Benedict-Carling/bugg-hardware-main/r6/src/README.txt

Stackup:
Total thickness 1.6mm

Silk
Resist 25um 
F.Cu 35um
Prepreg 0.22mm
In1.Cu 35um
Core 0.3mm
In2.Cu 35um
Prepreg 0.33mm
In3.Cu 35um
Core 0.3mm
In4.Cu 35um
Prepreg 0.22mm
B.Cu 35um
Resist 25um
Silk

DK prepreg assumed: 4.2
Finish: ENIG
Silk: White
Resist: Black, vias tented

See Mousebites-Forbid layer for areas in which mousebites should not be placed.
Mousebites can be placed anywhere on Mic and LED boards.
