Benedict-Carling/bugg-hardware-main/r6/src/bugg-main-r6.kicad_pcb

## KiCad design r6/src/bugg-main-r6.kicad_pcb (2026-09-28)

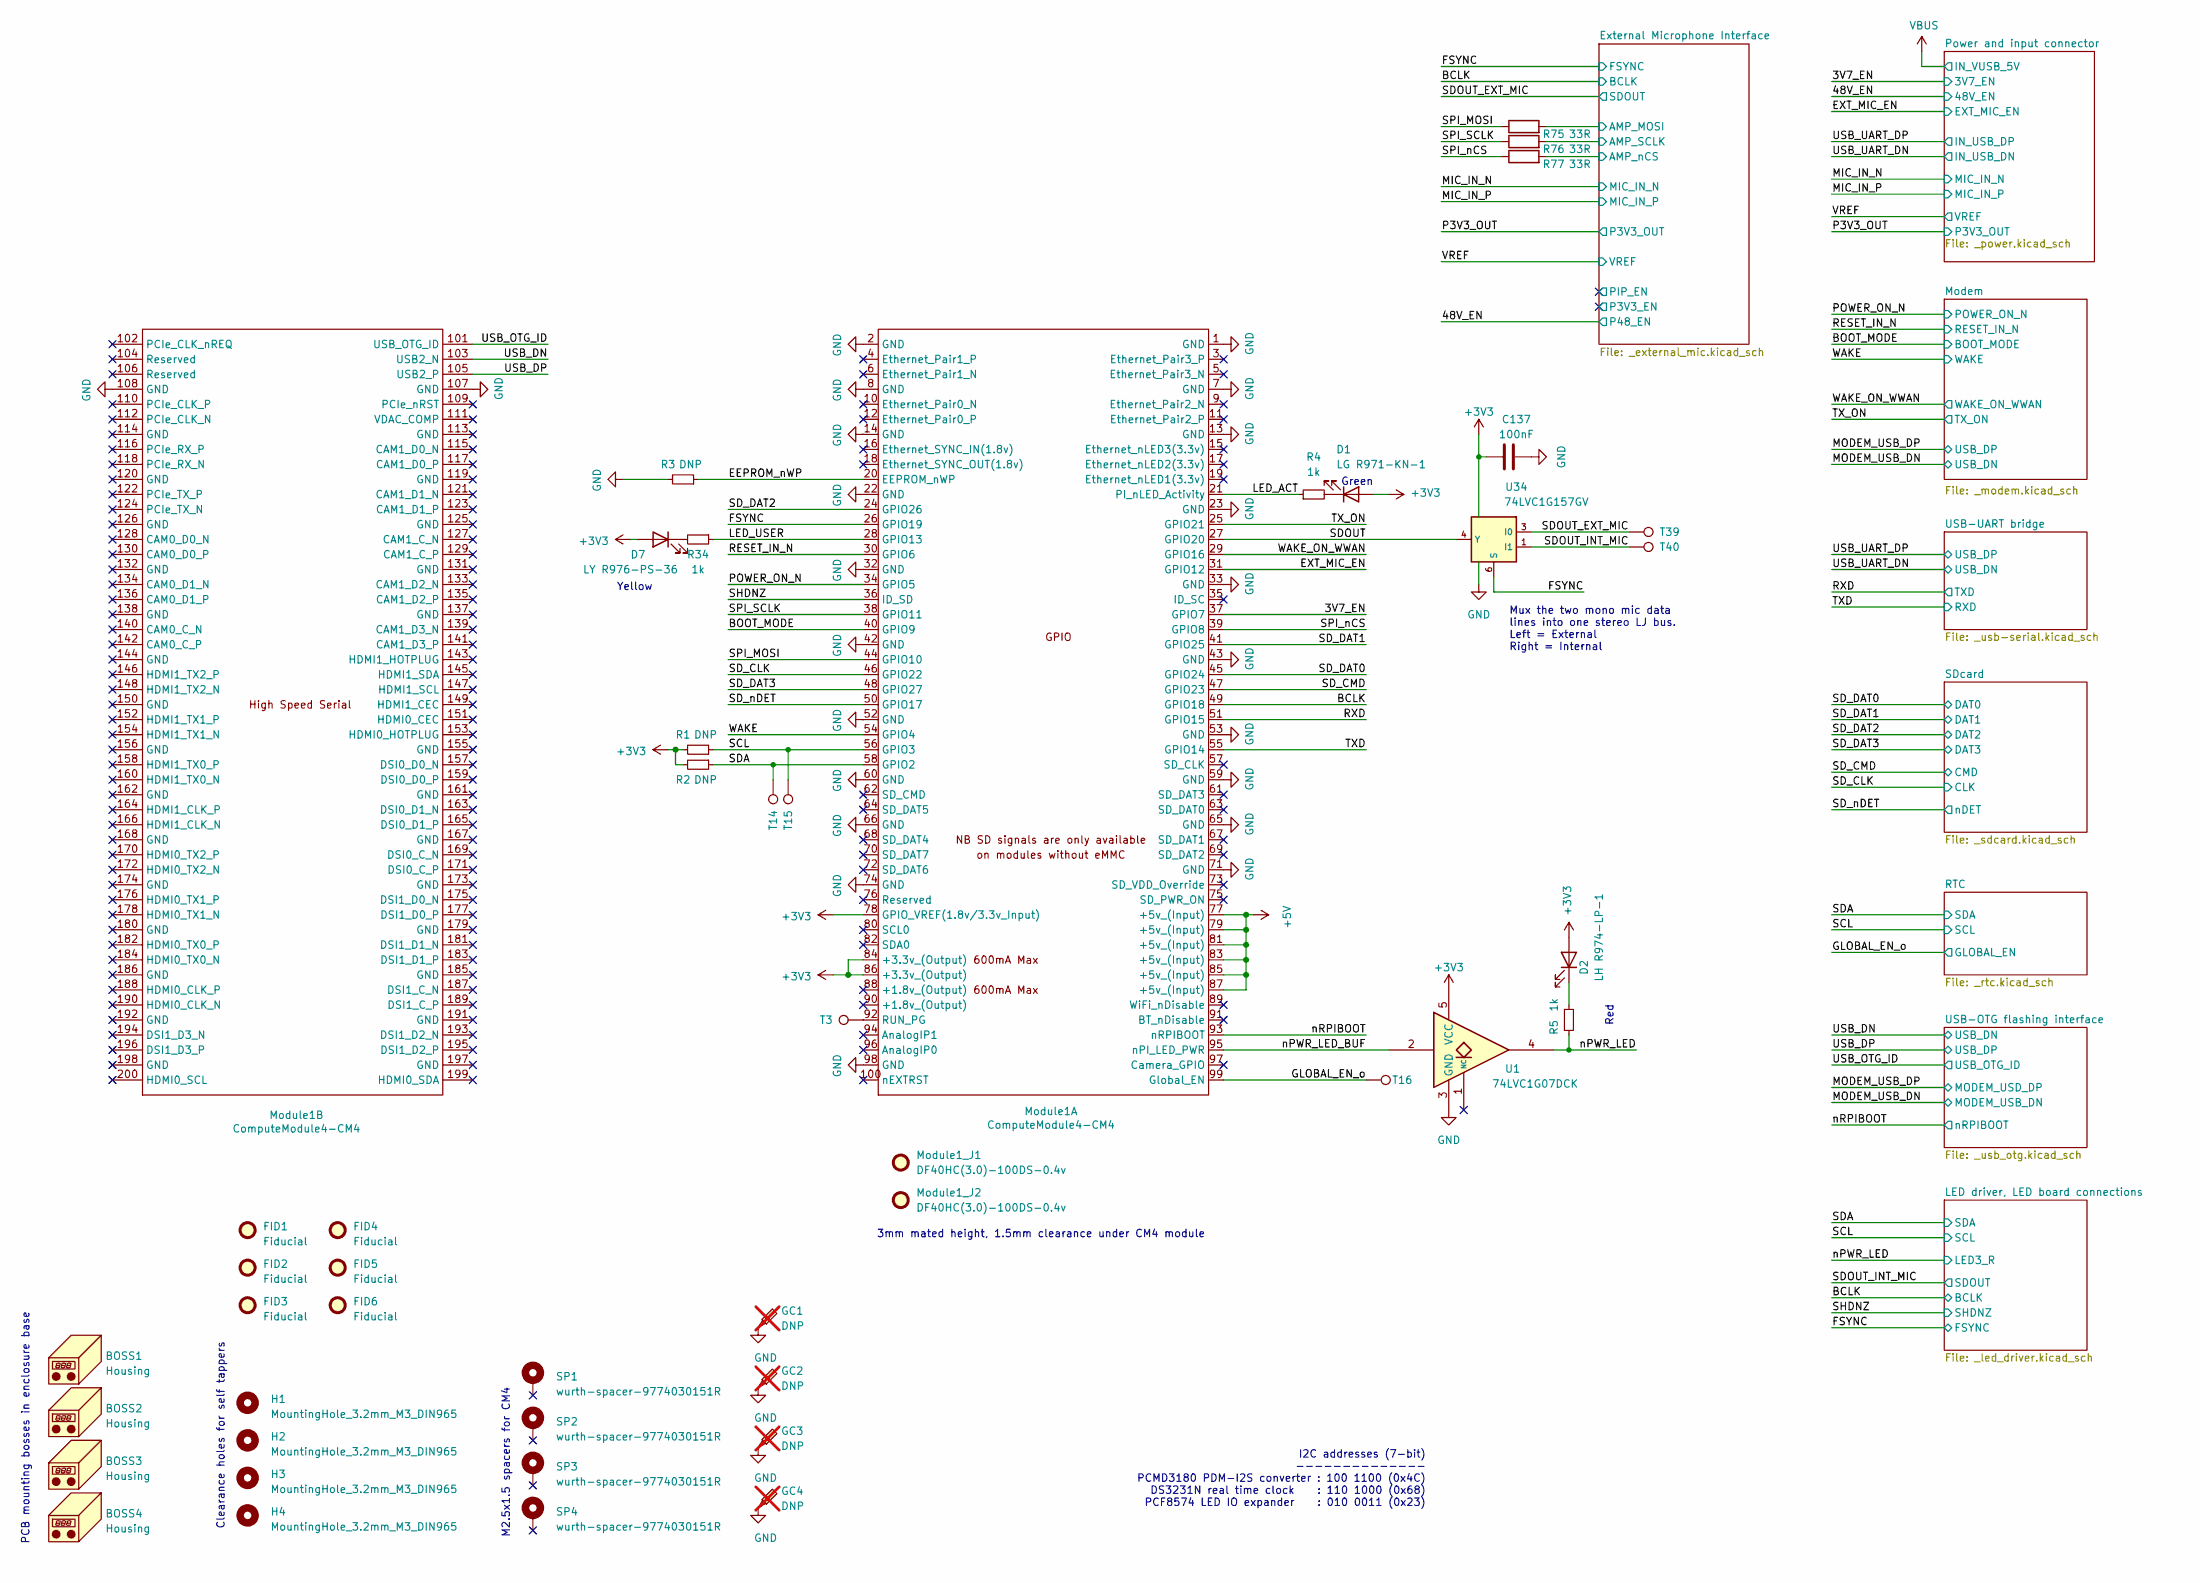
[picture p1: schematic bugg-main-r6.kicad_sch]

Parts:
BOSS1, BOSS2, BOSS3, BOSS4: Housing; bugg-pcb-boss
C137: 100nF; C_0402_1005Metric; Voltage 50V; MPN GRM155R71H104KE14D; Mouser 81-GRM155R71H104KE4D
D1: LG R971-KN-1; CHIPLED-0805; MPN LGR971-KN-1; Digikey 475-1410-6-ND
D2: LH R974-LP-1; CHIPLED-0805; MPN LHR974-LP-1; Digikey 475-1415-6-ND
D7: LY R976-PS-36; CHIPLED-0805; MPN LYR976-PS-36; Digikey 475-2560-6-ND
FID1, FID2, FID3, FID4, FID5, FID6: Fiducial; Fiducial_1mm_Mask2mm
GC1, GC2, GC3, GC4: DNP; TestPoint_Keystone_5019_Minature; MPN 5019; Mouser 534-5019; not fitted
H1, H2, H3, H4: MountingHole_3.2mm_M3_DIN965
Module1: ComputeModule4-CM4; Raspberry-Pi-4-Compute-Module-no-holes; MPN CM4002016; Farnell 3563481
Module1_J1, Module1_J2: DF40HC(3.0)-100DS-0.4v; MPN DF40HC(3.0)-100DS-0.4v; Digikey H124602DKR-ND
R1, R2, R3: DNP; R_0402_1005Metric
R4, R5, R34: 1k; R_0402_1005Metric
R75, R76, R77: 33R; R_0402_1005Metric
SP1, SP2, SP3, SP4: wurth-spacer-9774030151R; wurth-spacer-WA-SMSI-9774030151R; MPN 9774030151R; Digikey 732-7083-6-ND
T3, T14, T15, T16, T39, T40: TestPoint_Pad_D1.0mm
U1: 74LVC1G07DCK; SOT-353_SC-70-5; MPN SN74LVC1G07DCKT; Digikey 296-26591-6-ND
U34: 74LVC1G157GV; SC-74-6_1.5x2.9mm_P0.95mm; MPN 74LVC1G157GV; Mouser 771-74LVC1G157GVQ100

Connections:
+3V3: C137.2, D1.2 (A), D2.2 (A), D7.2 (A), Module1.78 (GPIO_VREF(1.8v/3.3v_Input)), Module1.84 (+3.3v_(Output)), Module1.86 (+3.3v_(Output)), R1.2, R2.2, U1.5 (VCC), U34.5 (VCC); also elsewhere on the board
+5V: Module1.77 (+5v_(Input)), Module1.79 (+5v_(Input)), Module1.81 (+5v_(Input)), Module1.83 (+5v_(Input)), Module1.85 (+5v_(Input)), Module1.87 (+5v_(Input)); also elsewhere on the board
/3V7_EN: Module1.37 (GPIO7); also elsewhere on the board
/BCLK: Module1.49 (GPIO18); also elsewhere on the board
/BOOT_MODE: Module1.40 (GPIO9); also elsewhere on the board
/EEPROM_nWP: Module1.20 (EEPROM_nWP), R3.1
/EXT_MIC_EN: Module1.31 (GPIO12); also elsewhere on the board
/External Microphone Interface/AMP_MOSI: R75.2; also elsewhere on the board
/External Microphone Interface/AMP_SCLK: R76.2; also elsewhere on the board
/External Microphone Interface/AMP_nCS: R77.2; also elsewhere on the board
/FSYNC: Module1.26 (GPIO19), U34.6 (S); also elsewhere on the board
/GLOBAL_EN_o: Module1.99 (Global_EN), T16.1; also elsewhere on the board
/LED_ACT: Module1.21 (PI_nLED_Activity), R4.1
/LED_USER: Module1.28 (GPIO13), R34.1
/POWER_ON_N: Module1.34 (GPIO5); also elsewhere on the board
/RESET_IN_N: Module1.30 (GPIO6); also elsewhere on the board
/RXD: Module1.51 (GPIO15); also elsewhere on the board
/SCL: Module1.56 (GPIO3), R1.1, T15.1; also elsewhere on the board
/SDA: Module1.58 (GPIO2), R2.1, T14.1; also elsewhere on the board
/SDOUT: Module1.27 (GPIO20), U34.4 (Y)
/SDOUT_EXT_MIC: T39.1, U34.3 (I0); also elsewhere on the board
/SDOUT_INT_MIC: T40.1, U34.1 (I1); also elsewhere on the board
/SD_CLK: Module1.46 (GPIO22); also elsewhere on the board
/SD_CMD: Module1.47 (GPIO23); also elsewhere on the board
/SD_DAT0: Module1.45 (GPIO24); also elsewhere on the board
/SD_DAT1: Module1.41 (GPIO25); also elsewhere on the board
/SD_DAT2: Module1.24 (GPIO26); also elsewhere on the board
/SD_DAT3: Module1.48 (GPIO27); also elsewhere on the board
/SD_nDET: Module1.50 (GPIO17); also elsewhere on the board
/SHDNZ: Module1.36 (ID_SD); also elsewhere on the board
/SPI_MOSI: Module1.44 (GPIO10), R75.1
/SPI_SCLK: Module1.38 (GPIO11), R76.1
/SPI_nCS: Module1.39 (GPIO8), R77.1
/TXD: Module1.55 (GPIO14); also elsewhere on the board
/TX_ON: Module1.25 (GPIO21); also elsewhere on the board
/USB_DN: Module1.103 (USB2_N); also elsewhere on the board
/USB_DP: Module1.105 (USB2_P); also elsewhere on the board
/USB_OTG_ID: Module1.101 (USB_OTG_ID); also elsewhere on the board
/WAKE: Module1.54 (GPIO4); also elsewhere on the board
/WAKE_ON_WWAN: Module1.29 (GPIO16); also elsewhere on the board
/nPWR_LED: R5.1, U1.4; also elsewhere on the board
/nPWR_LED_BUF: Module1.95 (nPI_LED_PWR), U1.2
/nRPIBOOT: Module1.93 (nRPIBOOT); also elsewhere on the board
GND: C137.1, GC1.1, GC2.1, GC3.1, GC4.1, Module1.1 (GND), Module1.2 (GND), Module1.7 (GND), Module1.8 (GND), Module1.13 (GND), Module1.14 (GND), Module1.22 (GND), Module1.23 (GND), Module1.32 (GND), Module1.33 (GND), Module1.42 (GND), Module1.43 (GND), Module1.52 (GND), Module1.53 (GND), Module1.59 (GND), Module1.60 (GND), Module1.65 (GND), Module1.66 (GND), Module1.71 (GND), Module1.74 (GND), Module1.98 (GND), Module1.107 (GND), Module1.108 (GND), R3.2, U1.3 (GND), U34.2 (GND); also elsewhere on the board
unnamed: D1.1 (K), R4.2
unnamed: D2.1 (K), R5.2
unnamed: D7.1 (K), R34.2
unnamed: Module1.92 (RUN_PG), T3.1

Notes on the sheet:
Yellow
Red
Mux the two mono mic data lines into one stereo LJ bus. Left = External Right = Internal
Green
3mm mated height, 1.5mm clearance under CM4 module
PCB mounting bosses in enclosure base
Clearance holes for self tappers
I2C addresses (7-bit) -------------- PCMD3180 PDM-I2S converter : 100 1100 (0x4C) DS3231N real time clock : 110 1000 (0x68) PCF8574 LED IO expander : 010 0011 (0x23)
M2.5x1.5 spacers for CM4

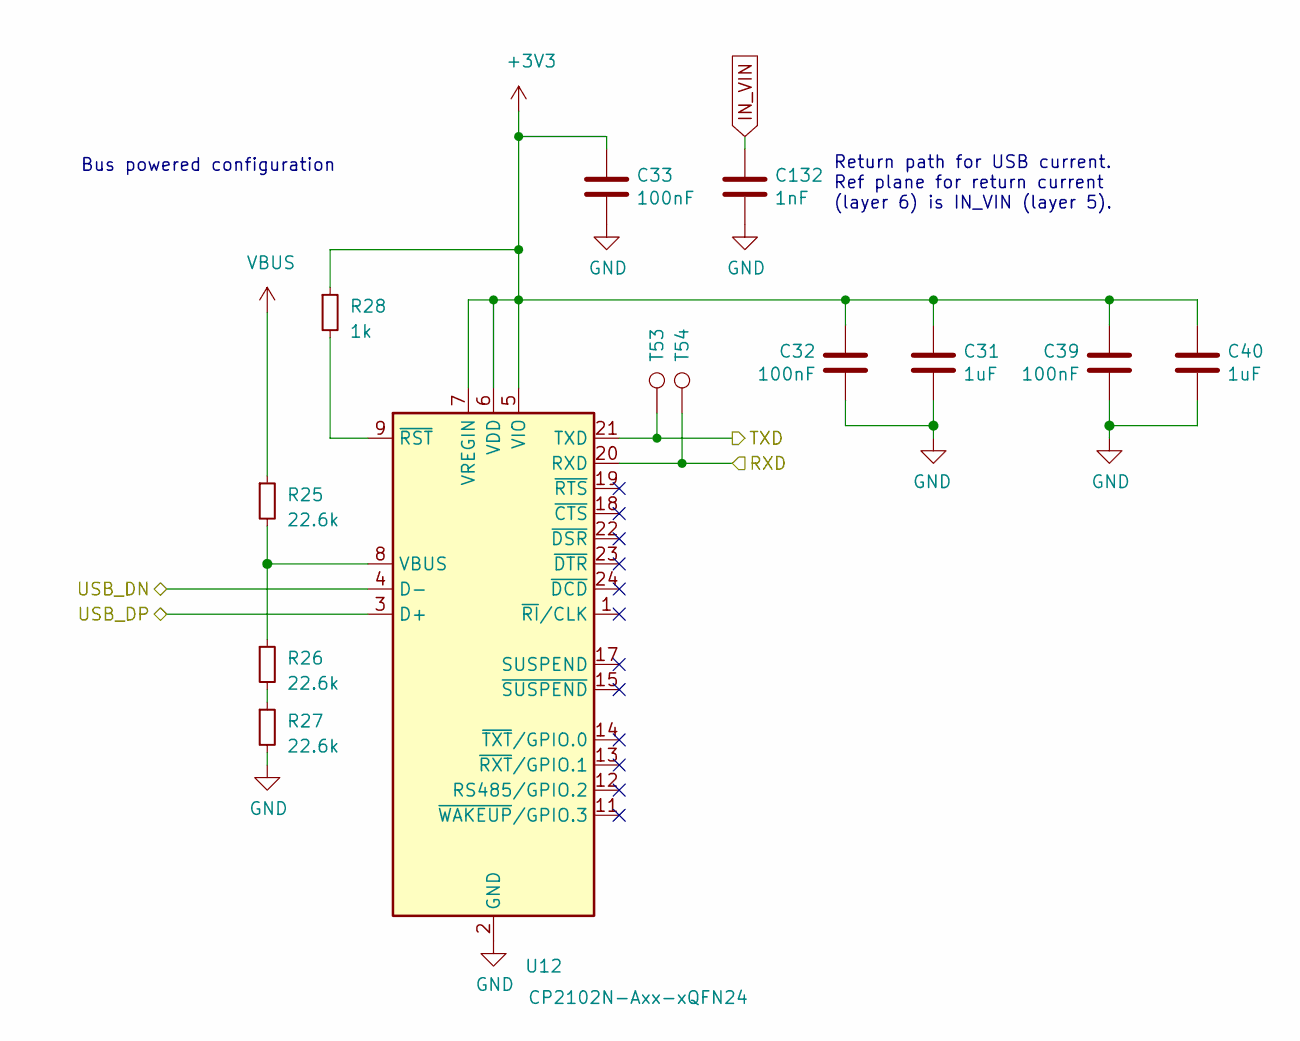
[picture p2: schematic _usb-serial.kicad_sch]

Parts:
C31, C40: 1uF; C_0402_1005Metric; Voltage 6.3V; MPN GRM155C81C105KE15D; Mouser 81-GRM155C81C105KE5D
C32, C33, C39: 100nF; C_0402_1005Metric; Voltage 50V; MPN GRM155R71H104KE14D; Mouser 81-GRM155R71H104KE4D
C132: 1nF; C_0402_1005Metric
R25, R26, R27: 22.6k; R_0402_1005Metric
R28: 1k; R_0402_1005Metric
T53, T54: TestPoint_Pad_D1.0mm
U12: CP2102N-Axx-xQFN24; QFN-24-1EP_4x4mm_P0.5mm_EP2.6x2.6mm; MPN CP2102N-A02-GQFN24R; Digikey 336-5888-6-ND

Connections:
+3V3: C31.1, C32.1, C33.1, C39.1, C40.1, R28.1, U12.5 (VIO), U12.6 (VDD), U12.7 (VREGIN); also elsewhere on the board
/RXD: T53.1, U12.21 (TXD); also elsewhere on the board
/TXD: T54.1, U12.20 (RXD); also elsewhere on the board
/USB_UART_DN: U12.4 (D-); also elsewhere on the board
/USB_UART_DP: U12.3 (D+); also elsewhere on the board
GND: C31.2, C32.2, C33.2, C39.2, C40.2, C132.2, R27.2, U12.2 (GND), U12.25 (GND); also elsewhere on the board
IN_VIN: C132.1; also elsewhere on the board
unnamed: R26.2, R27.1
unnamed: R25.2, R26.1, U12.8 (VBUS)
unnamed: R28.2, U12.9 (~RST)
VBUS: R25.1; also elsewhere on the board

Notes on the sheet:
Return path for USB current. Ref plane for return current (layer 6) is IN_VIN (layer 5).
Bus powered configuration

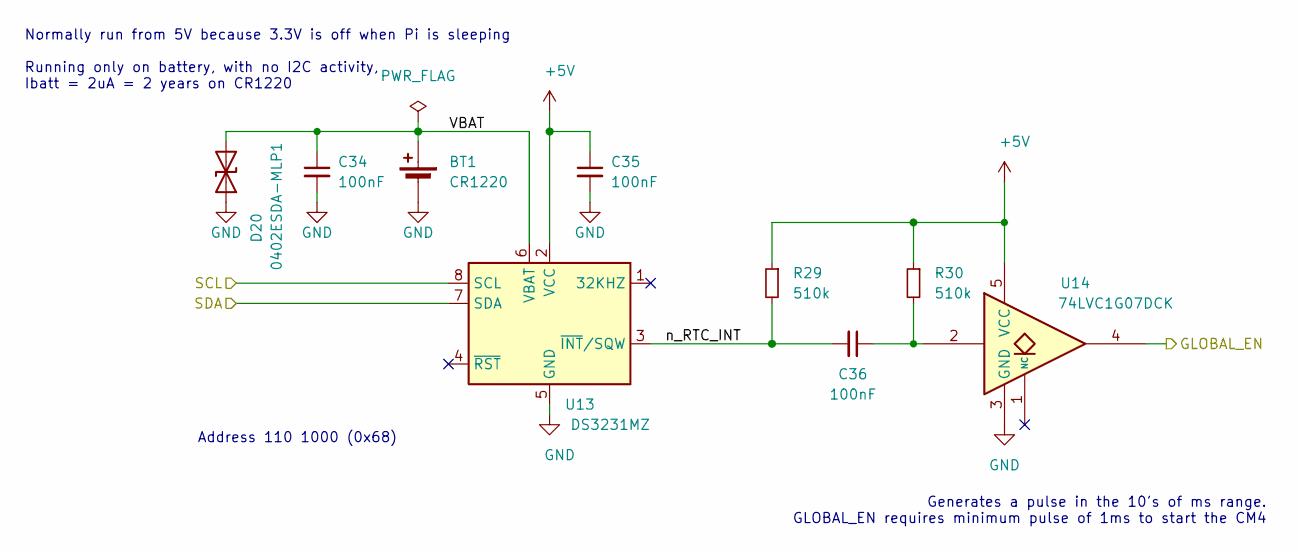
[picture p3: schematic _rtc.kicad_sch]

Parts:
BT1: CR1220; Keystone-3000-CR1220-CR1216; MPN 3000TR; Digikey 36-3000CT-ND
C34, C35, C36: 100nF; C_0402_1005Metric; Voltage 50V; MPN GRM155R71H104KE14D; Mouser 81-GRM155R71H104KE4D
D20: 0402ESDA-MLP1; D_0402_1005Metric; MPN 0402ESDA-MLP1; Digikey 283-2964-6-ND
R29, R30: 510k; R_0402_1005Metric
U13: DS3231MZ; SOIC-8_3.9x4.9mm_P1.27mm; MPN DS3231MZ+; Digikey DS3231MZ+-ND
U14: 74LVC1G07DCK; SOT-353_SC-70-5; MPN SN74LVC1G07DCKT; Digikey 296-26591-6-ND

Connections:
+5V: C35.1, R29.1, R30.1, U13.2 (VCC), U14.5 (VCC); also elsewhere on the board
/GLOBAL_EN_o: U14.4; also elsewhere on the board
/RTC/VBAT: BT1.1 (+), C34.1, D20.2 (A2), U13.6 (VBAT)
/RTC/n_RTC_INT: C36.2, R29.2, U13.3 (~INT/SQW)
/SCL: U13.8 (SCL); also elsewhere on the board
/SDA: U13.7 (SDA); also elsewhere on the board
GND: BT1.2 (-), C34.2, C35.2, D20.1 (A1), U13.5 (GND), U14.3 (GND); also elsewhere on the board
unnamed: C36.1, R30.2, U14.2

Notes on the sheet:
Generates a pulse in the 10's of ms range. GLOBAL_EN requires minimum pulse of 1ms to start the CM4
Address 110 1000 (0x68)
Normally run from 5V because 3.3V is off when Pi is sleeping Running only on battery, with no I2C activity, Ibatt = 2uA = 2 years on CR1220

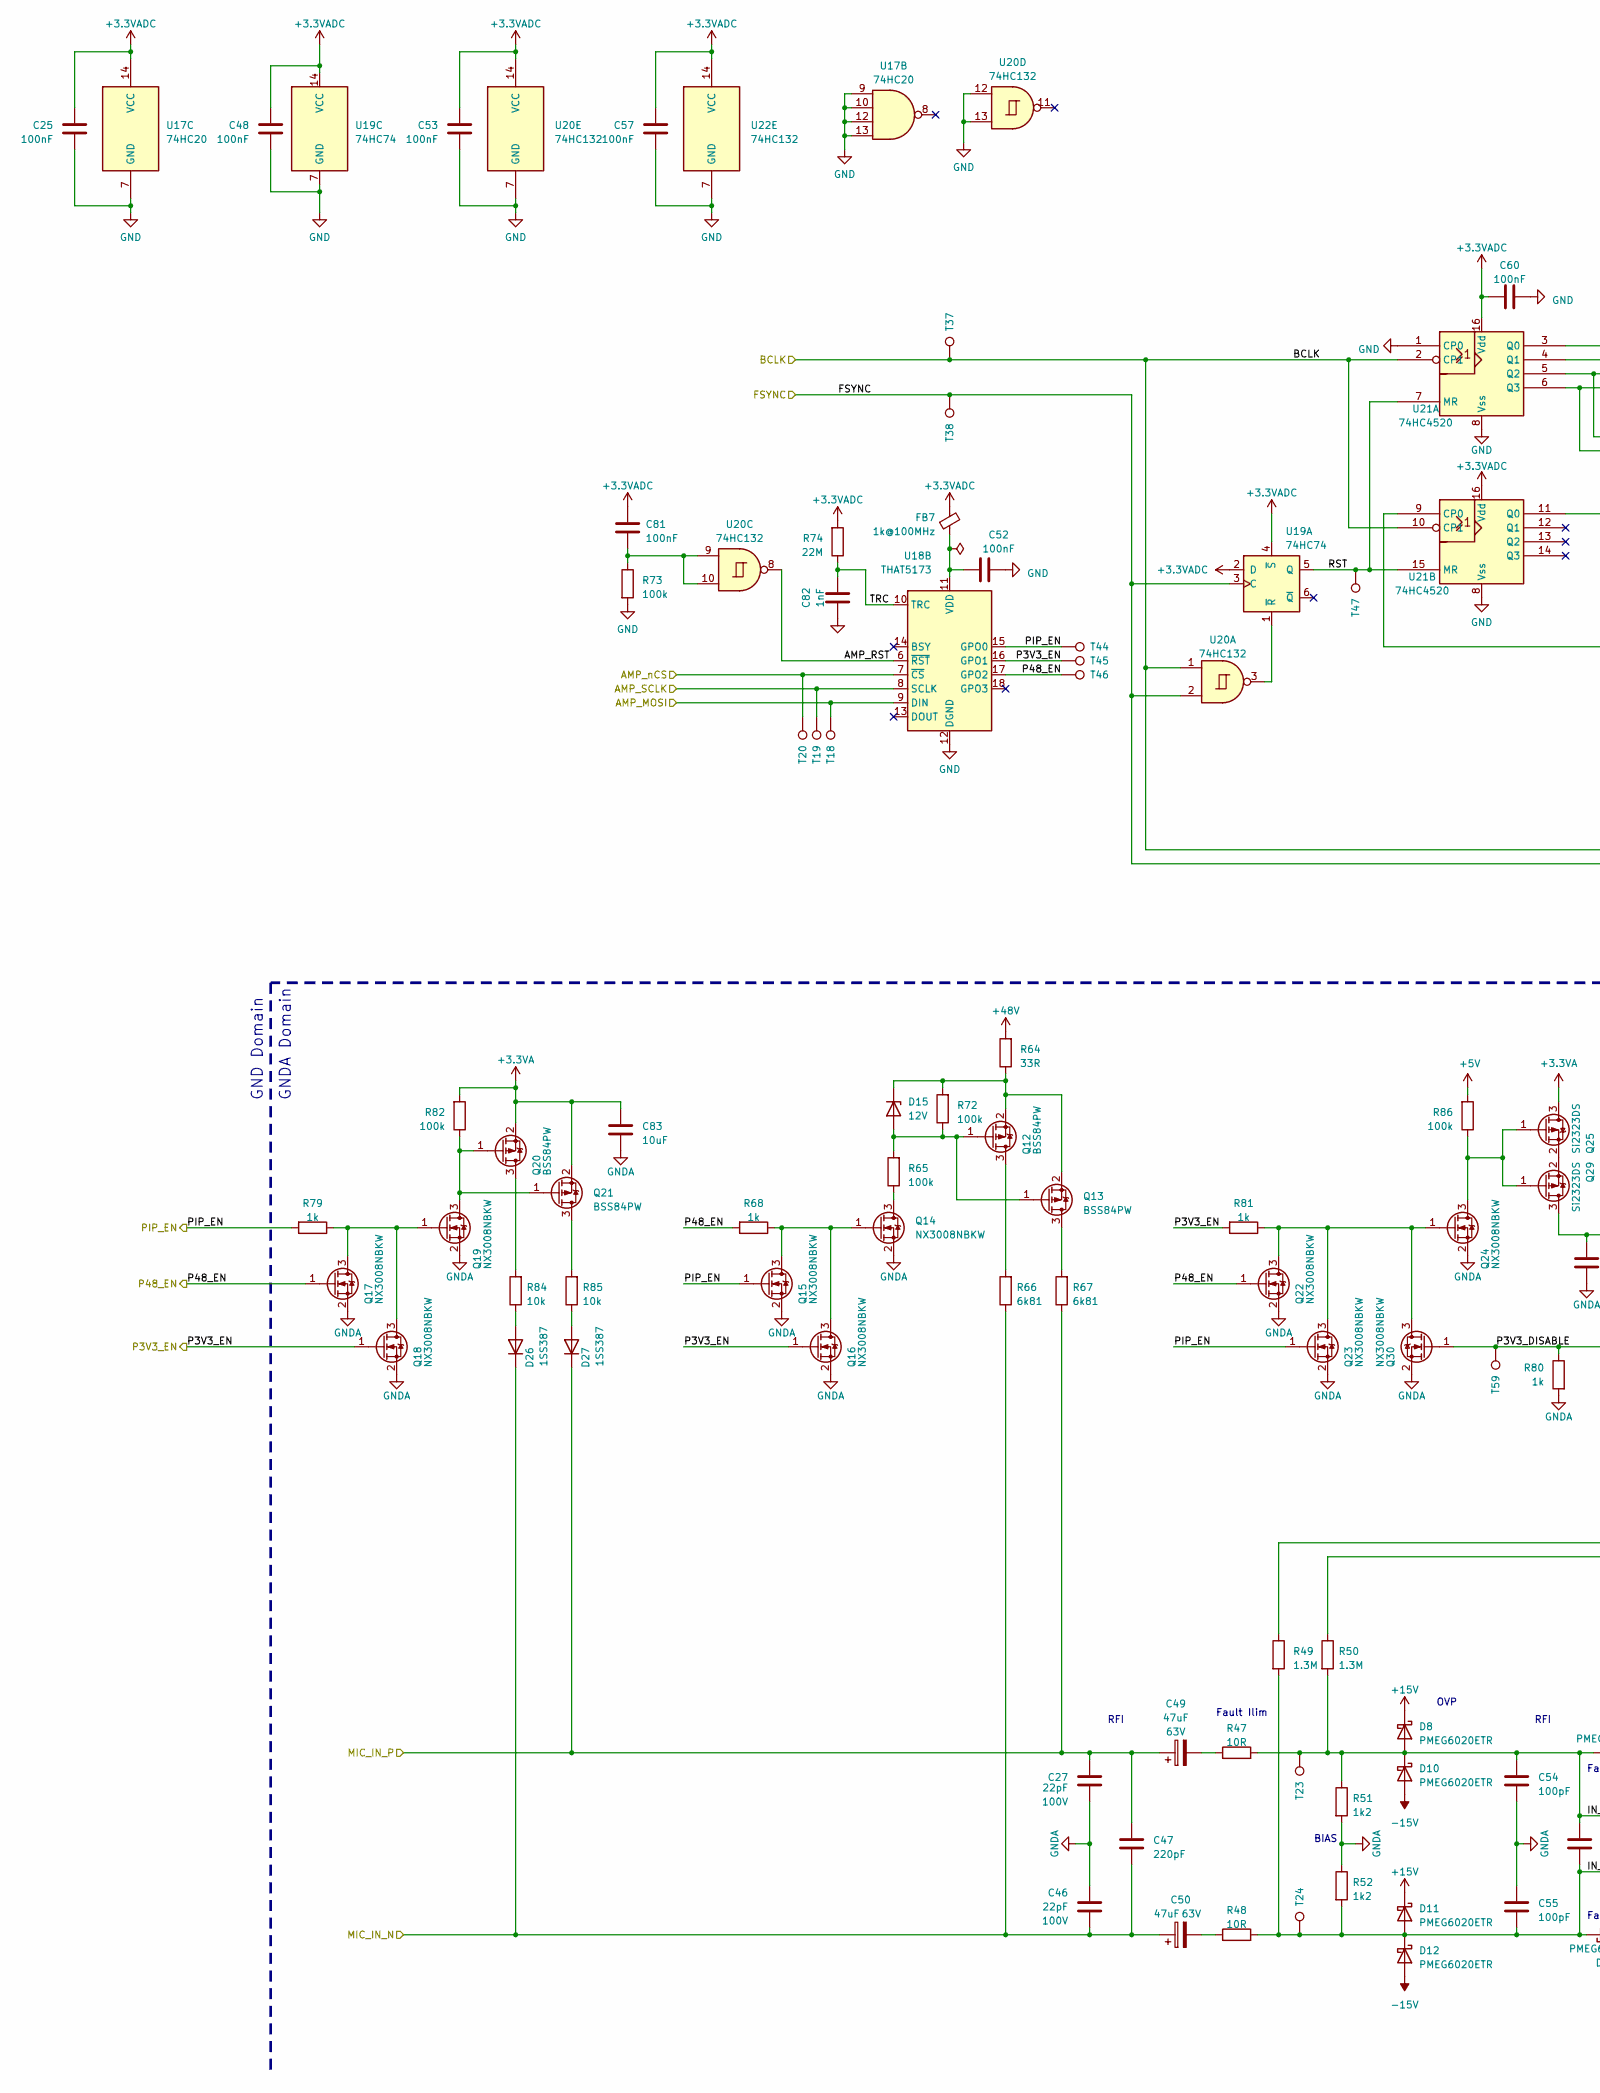
[picture p4: schematic _external_mic.kicad_sch, part in row 1, column 1]

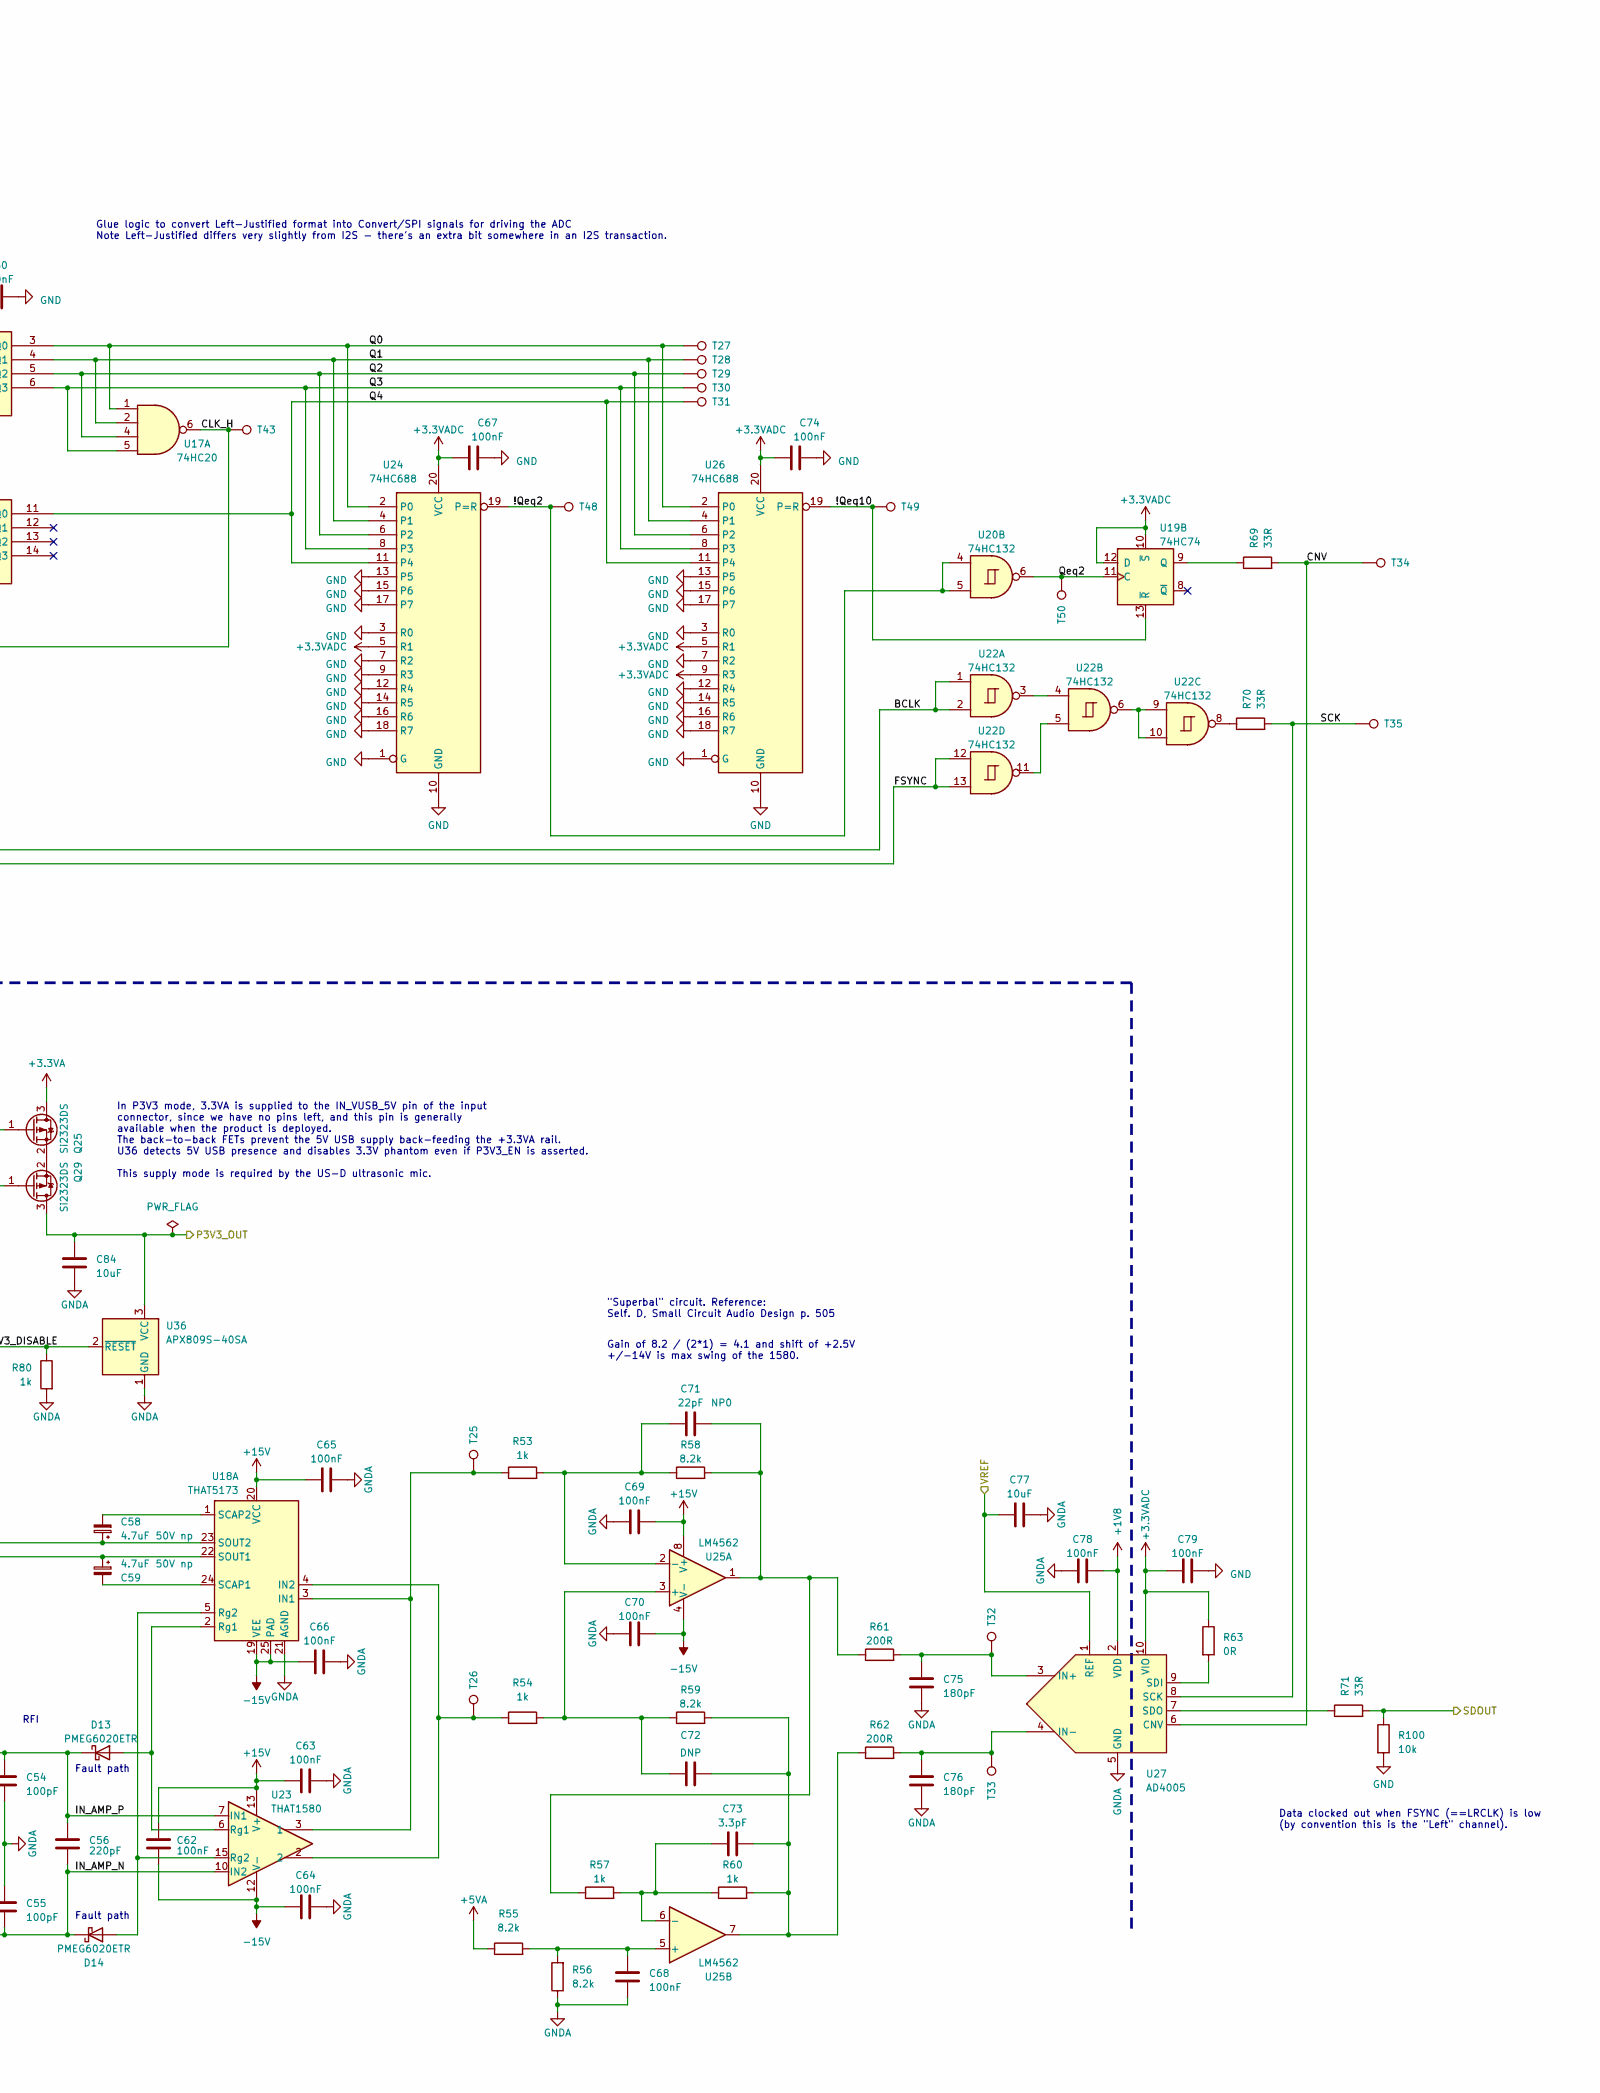
[picture p5: schematic _external_mic.kicad_sch, part in row 1, column 2]

Parts:
C25, C48, C52, C53, C57, C60, C62, C63, C64, C65, C66, C67, C68, C69, C70, C74, C78, C79, C81: 100nF; C_0402_1005Metric; Voltage 50V; MPN GRM155R71H104KE14D; Mouser 81-GRM155R71H104KE4D
C27, C46, C71: 22pF; C_0402_1005Metric; Voltage 100V
C47, C56: 220pF; C_0402_1005Metric
C49, C50: 47uF; CP_Elec_8x10.5; Voltage 63V; MPN EMVH630ADA470MHA0G; Mouser 565-4268-1-ND
C54, C55: 100pF; C_0402_1005Metric
C58, C59: 4.7uF; CP_Elec_5x5.4; Voltage 50V np; MPN 865250642008; Mouser 710-865250642008
C72: DNP; C_0402_1005Metric
C73: 3.3pF; C_0402_1005Metric
C75, C76: 180pF; C_0402_1005Metric
C77, C83, C84: 10uF; C_0603_1608Metric; Voltage 6.3V; MPN CL10A106MQ8NNNC; Mouser 187-CL10A106MQ8NNNC
C82: 1nF; C_0402_1005Metric
D8, D10, D11, D12, D13, D14: PMEG6020ETR; Nexperia_CFP3_SOD-123W; MPN PMEG6020ETR,115; Digikey 1727-1347-1-ND
D15: 12V; D_SOD-123; MPN BZT52C12-13-F; Digikey BZT52C1213-FDIDKR-ND
D26, D27: 1SS387; D_SOD-523; MPN 1SS387,L3F; Mouser 757-1SS387L3F
FB7: 1k@100MHz; L_0603_1608Metric; MPN BLM18KG102SN1D; Digikey 490-17349-1-ND
Q12, Q13, Q20, Q21: BSS84PW; SOT-323_SC-70; MPN BSS84PW; Mouser 726-BSS84PWH6327XTSA
Q14, Q15, Q16, Q17, Q18, Q19, Q22, Q23, Q24, Q30: NX3008NBKW; SOT-323_SC-70; MPN NX3008NBKW; Digikey 1727-1280-6-ND
Q25, Q29: Si2323DS; SOT-23; MPN SI2323DS-T1
R47, R48: 10R; R_1206_3216Metric; Tolerance 0.1%
R49, R50: 1.3M; R_0402_1005Metric
R51, R52: 1k2; R_0402_1005Metric; Tolerance 0.1% thin film; MPN ERA-2AEB122X; Mouser 667-ERA-2AEB122X
R53, R54, R57, R60: 1k; R_0402_1005Metric; Tolerance 0.1% thin film; MPN ERA-2AEB102X; Mouser 667-ERA-2AEB102X
R55, R56, R58, R59: 8.2k; R_0402_1005Metric; Tolerance 0.1% thin film; MPN ERA-2AEB822X; Mouser 667-ERA-2AEB822X
R61, R62: 200R; R_0402_1005Metric; Tolerance 0.1% thin film; MPN ERA-2AEB201X; Mouser 667-ERA-2AEB201X
R63: 0R; R_0402_1005Metric
R64, R69, R70, R71: 33R; R_0402_1005Metric
R65, R72, R73, R82, R86: 100k; R_0402_1005Metric
R66, R67: 6k81; R_1206_3216Metric
R68, R79, R80, R81: 1k; R_0402_1005Metric
R74: 22M; R_0402_1005Metric
R84, R85, R100: 10k; R_0402_1005Metric
T18, T19, T20, T23, T24, T25, T26, T27, T28, T29, T30, T31, T32, T33, T34, T35, T37, T38, T43, T44, T45, T46, T47, T48, T49, T50, T59: TestPoint_Pad_D1.0mm
U17: 74HC20; TSSOP-14_4.4x5mm_P0.65mm; MPN 74HC20PW; Mouser 771-HC20PW118
U18: THAT5173; QFN-24-1EP_5x5mm_P0.65mm_EP3.4x3.4mm_ThermalVias; MPN 5173N24-U; Mouser 887-5173N24-U
U19: 74HC74; TSSOP-14_4.4x5mm_P0.65mm; MPN 74HC74PW; Mouser 771-74HC74PW-T
U20, U22: 74HC132; TSSOP-14_4.4x5mm_P0.65mm; MPN 74HC132PW; Mouser 771-74HC132PW-T
U21: 74HC4520; TSSOP-16_4.4x5mm_P0.65mm; MPN 74HC4520PW; Mouser 771-HC4520PW118
U23: THAT1580; QFN-16-1EP_4x4mm_P0.65mm_EP2.1x2.1mm_ThermalVias; MPN 1580N16-U; Mouser 887-1580N16-U
U24, U26: 74HC688; TSSOP-20_4.4x6.5mm_P0.65mm; MPN 74HC688PW; Mouser 771-HC688PW118
U25: LM4562; SOIC-8_3.9x4.9mm_P1.27mm; MPN LM4562MA; Mouser 926-LM4562MAX/NOPB
U27: AD4005; MSOP-10_3x3mm_P0.5mm; MPN AD4005BRMZ; Mouser 584-AD4005BRMZ
U36: APX809S-40SA; SOT-23; MPN APX809S-40SA; Mouser 621-APX809S-40SA-7

Connections:
+1V8: C78.2, U27.2 (VDD); also elsewhere on the board
+3.3VA: C83.2, Q20.2 (S), Q21.2 (S), Q25.3 (D), R82.2; also elsewhere on the board
+3.3VADC: C25.2, C48.2, C53.2, C57.2, C60.2, C67.2, C74.2, C79.2, C81.1, FB7.2, R63.1, R74.2, U17.14 (VCC), U19.2 (D), U19.4 (~S), U19.10 (~S), U19.12 (D), U19.14 (VCC), U20.14 (VCC), U21.16 (Vdd), U22.14 (VCC), U24.5 (R1), U24.20 (VCC), U26.5 (R1), U26.9 (R3), U26.20 (VCC), U27.10 (VIO); also elsewhere on the board
+5V: R86.2; also elsewhere on the board
+5VA: R55.1; also elsewhere on the board
+15V: C62.1, C63.2, C65.2, C69.2, D8.1 (K), D11.1 (K), U18.20 (VCC), U23.13 (V+), U25.8 (V+); also elsewhere on the board
+48V: R64.2; also elsewhere on the board
-15V: C62.2, C64.1, C66.2, C70.1, D10.2 (A), D12.2 (A), U18.19 (VEE), U18.25 (PAD), U23.12 (V-), U23.17 (V-), U25.4 (V-); also elsewhere on the board
/48V_EN: Q17.1 (G), Q22.1 (G), R68.2, T46.1, U18.17 (GPO2); also elsewhere on the board
/BCLK: T37.1, U20.1, U21.2 (CP1), U21.10 (CP1), U22.1, U22.2; also elsewhere on the board
/External Microphone Interface/!Qeq2: T48.1, U20.4, U20.5, U24.19 (P=R)
/External Microphone Interface/!Qeq10: T49.1, U19.13 (~R), U26.19 (P=R)
/External Microphone Interface/AMP_MOSI: T18.1, U18.9 (DIN); also elsewhere on the board
/External Microphone Interface/AMP_RST: U18.6 (~RST), U20.8
/External Microphone Interface/AMP_SCLK: T19.1, U18.8 (SCLK); also elsewhere on the board
/External Microphone Interface/AMP_nCS: T20.1, U18.7 (~CS); also elsewhere on the board
/External Microphone Interface/CLK_H: T43.1, U17.6, U21.9 (CP0)
/External Microphone Interface/CNV: R69.2, T34.1, U27.6 (CNV)
/External Microphone Interface/IN_AMP_N: C55.1, C56.1, D11.2 (A), D12.1 (K), D14.1 (K), R48.2, R49.2, R52.2, T24.1, U23.10 (IN2)
/External Microphone Interface/IN_AMP_P: C54.2, C56.2, D8.2 (A), D10.1 (K), D13.1 (K), R47.2, R50.2, R51.1, T23.1, U23.7 (IN1)
/External Microphone Interface/P3V3_DISABLE: Q30.1 (G), R80.1, T59.1, U36.2 (~RESET)
/External Microphone Interface/P3V3_EN: Q16.1 (G), Q18.1 (G), R81.2, T45.1, U18.16 (GPO1)
/External Microphone Interface/PIP_EN: Q15.1 (G), Q23.1 (G), R79.2, T44.1, U18.15 (GPO0)
/External Microphone Interface/Q0: T27.1, U17.1, U21.3 (Q0), U24.2 (P0), U26.2 (P0)
/External Microphone Interface/Q1: T28.1, U17.2, U21.4 (Q1), U24.4 (P1), U26.4 (P1)
/External Microphone Interface/Q2: T29.1, U17.4, U21.5 (Q2), U24.6 (P2), U26.6 (P2)
/External Microphone Interface/Q3: T30.1, U17.5, U21.6 (Q3), U24.8 (P3), U26.8 (P3)
/External Microphone Interface/Q4: T31.1, U21.11 (Q0), U24.11 (P4), U26.11 (P4)
/External Microphone Interface/Qeq2: T50.1, U19.11 (C), U20.6
/External Microphone Interface/RST: T47.1, U19.5 (Q), U21.7 (MR), U21.15 (MR)
/External Microphone Interface/SCK: R70.2, T35.1, U27.8 (SCK)
/External Microphone Interface/TRC: C82.2, R74.1, U18.10 (TRC)
/FSYNC: T38.1, U19.3 (C), U20.2, U22.12, U22.13; also elsewhere on the board
/MIC_IN_N: C46.1, C47.1, C50.1, D26.1 (K), R66.1; also elsewhere on the board
/MIC_IN_P: C27.2, C47.2, C49.1, D27.1 (K), R67.1; also elsewhere on the board
/P3V3_OUT: C84.2, Q29.3 (D), U36.3 (VCC); also elsewhere on the board
/SDOUT_EXT_MIC: R71.2, R100.1; also elsewhere on the board
/VREF: C77.2, U27.1 (REF); also elsewhere on the board
GND: C25.1, C48.1, C52.1, C53.1, C57.1, C60.1, C67.1, C74.1, C79.1, C82.1, R73.2, R100.2, U17.7 (GND), U17.9, U17.10, U17.12, U17.13, U18.12 (DGND), U19.7 (GND), U20.7 (GND), U20.12, U20.13, U21.1 (CP0), U21.8 (Vss), U22.7 (GND), U24.1 (G), U24.3 (R0), U24.7 (R2), U24.9 (R3), U24.10 (GND), U24.12 (R4), U24.13 (P5), U24.14 (R5), U24.15 (P6), U24.16 (R6), U24.17 (P7), U24.18 (R7), U26.1 (G), U26.3 (R0), U26.7 (R2), U26.10 (GND), U26.12 (R4), U26.13 (P5), U26.14 (R5), U26.15 (P6), U26.16 (R6), U26.17 (P7), U26.18 (R7); also elsewhere on the board
GNDA: C27.1, C46.2, C54.1, C55.2, C63.1, C64.2, C65.1, C66.1, C68.2, C69.1, C70.2, C75.2, C76.2, C77.1, C78.1, C83.1, C84.1, Q14.2 (S), Q15.2 (S), Q16.2 (S), Q17.2 (S), Q18.2 (S), Q19.2 (S), Q22.2 (S), Q23.2 (S), Q24.2 (S), Q30.2 (S), R51.2, R52.1, R56.1, R80.2, U18.21 (AGND), U27.5 (GND), U36.1 (GND); also elsewhere on the board
unnamed: C49.2, R47.1
unnamed: C50.2, R48.1
unnamed: C71.2, R57.1, R58.2, R61.1, U25.1
unnamed: C72.2, C73.2, R59.2, R60.2, R62.1, U25.7
unnamed: C81.2, R73.1, U20.9, U20.10
unnamed: D13.2 (A), U18.2 (Rg1), U23.6 (Rg1)
unnamed: D14.2 (A), U18.5 (Rg2), U23.15 (Rg2)
unnamed: D15.2 (A), Q12.1 (G), Q13.1 (G), R65.2, R72.1
unnamed: D15.1 (K), Q12.2 (S), Q13.2 (S), R64.1, R72.2
unnamed: D26.2 (A), R84.1
unnamed: D27.2 (A), R85.1
unnamed: Q12.3 (D), R66.2
unnamed: Q13.3 (D), R67.2
unnamed: Q14.3 (D), R65.1
unnamed: Q14.1 (G), Q15.3 (D), Q16.3 (D), R68.1
unnamed: Q17.3 (D), Q18.3 (D), Q19.1 (G), R79.1
unnamed: Q19.3 (D), Q20.1 (G), Q21.1 (G), R82.1
unnamed: Q20.3 (D), R84.2
unnamed: Q21.3 (D), R85.2
unnamed: Q22.3 (D), Q23.3 (D), Q24.1 (G), Q30.3 (D), R81.1
unnamed: Q24.3 (D), Q25.1 (G), Q29.1 (G), R86.1
unnamed: Q25.2 (S), Q29.2 (S)
unnamed: R70.1, U22.8
unnamed: R53.1, T25.1, U18.3 (IN1), U23.3 (1)
unnamed: R54.1, T26.1, U18.4 (IN2), U23.2
unnamed: C59.2, U18.24 (SCAP1)
unnamed: C58.2, U18.1 (SCAP2)
unnamed: C59.1, R50.1, U18.22 (SOUT1)
unnamed: C58.1, R49.1, U18.23 (SOUT2)
unnamed: C52.2, FB7.1, U18.11 (VDD)
unnamed: U19.1 (~R), U20.3
unnamed: R69.1, U19.9 (Q)
unnamed: U22.3, U22.4
unnamed: U22.6, U22.9, U22.10
unnamed: U22.5, U22.11
unnamed: C72.1, R54.2, R59.1, U25.3 (+)
unnamed: C71.1, R53.2, R58.1, U25.2 (-)
unnamed: C68.1, R55.2, R56.2, U25.5 (+)
unnamed: C73.1, R57.2, R60.1, U25.6 (-)
unnamed: C75.1, R61.2, T32.1, U27.3 (IN+)
unnamed: C76.1, R62.2, T33.1, U27.4 (IN-)
unnamed: R63.2, U27.9 (SDI)
unnamed: R71.1, U27.7 (SDO)

Notes on the sheet:
OVP
RFI
Fault path
BIAS
"Superbal" circuit. Reference: Self. D, Small Circuit Audio Design p. 505
Gain of 8.2 / (2*1) = 4.1 and shift of +2.5V +/-14V is max swing of the 1580.
Glue logic to convert Left-Justified format into Convert/SPI signals for driving the ADC Note Left-Justified differs very slightly from I2S - there's an extra bit somewhere in an I2S transaction.
Data clocked out when FSYNC (==LRCLK) is low (by convention this is the "Left" channel).
In P3V3 mode, 3.3VA is supplied to the IN_VUSB_5V pin of the input connector, since we have no pins left, and this pin is generally available when the product is deployed. The back-to-back FETs prevent the 5V USB supply back-feeding the +3.3VA rail. U36 detects 5V USB presence and disables 3.3V pha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
GNDA Domain
Fault Ilim
GND Domain
