Benedict-Carling/bugg-hardware-main/r6/src/bugg-main-r6.kicad_pcb

## KiCad design r6/src/bugg-main-r6.kicad_pcb (continued)

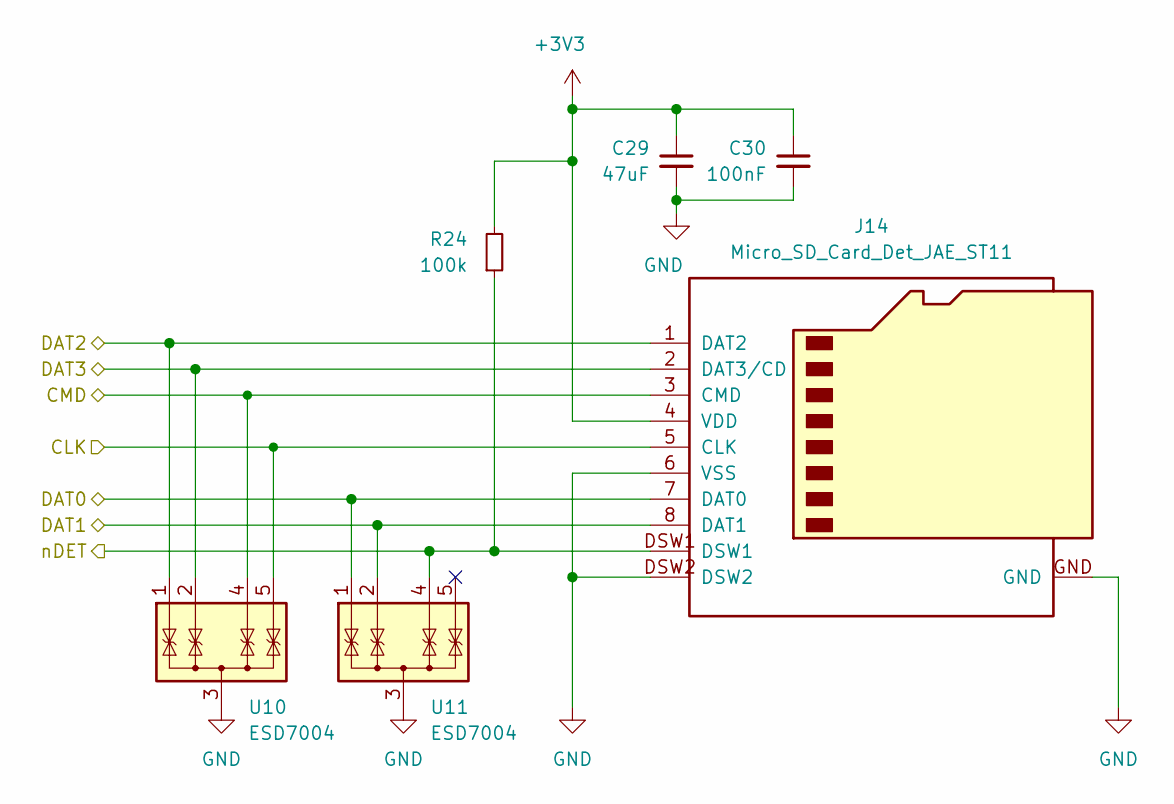
[picture p6: schematic _sdcard.kicad_sch]

Parts:
C29: 47uF; C_1206_3216Metric; Voltage 6.3V; MPN GRM31CE70J476ME15L; Mouser 81-GRM31CE70J476ME5L
C30: 100nF; C_0402_1005Metric; Voltage 50V; MPN GRM155R71H104KE14D; Mouser 81-GRM155R71H104KE4D
J14: Micro_SD_Card_Det_JAE_ST11; microSD_JAE_ST11S008V4H; MPN ST11S008V4HR2000; Digikey 670-2695-6-ND
R24: 100k; R_0402_1005Metric
U10, U11: ESD7004; USON-10_2.5x1.0mm_P0.5mm; MPN ESD7004MUTAG; Digikey ESD7004MUTAGOSDKR-ND

Connections:
+3V3: C29.1, C30.1, J14.4 (VDD), R24.2; also elsewhere on the board
/SD_CLK: J14.5 (CLK), U10.5 (IO4), U10.6; also elsewhere on the board
/SD_CMD: J14.3 (CMD), U10.4 (IO3), U10.7; also elsewhere on the board
/SD_DAT0: J14.7 (DAT0), U11.1 (IO1), U11.10; also elsewhere on the board
/SD_DAT1: J14.8 (DAT1), U11.2 (IO2), U11.9; also elsewhere on the board
/SD_DAT2: J14.1 (DAT2), U10.1 (IO1), U10.10; also elsewhere on the board
/SD_DAT3: J14.2 (DAT3/CD), U10.2 (IO2), U10.9; also elsewhere on the board
/SD_nDET: J14.DSW1, R24.1, U11.4 (IO3), U11.7; also elsewhere on the board
GND: C29.2, C30.2, J14.6 (VSS), J14.DSW2, J14.GND, U10.3 (G), U10.8, U11.3 (G), U11.8; also elsewhere on the board

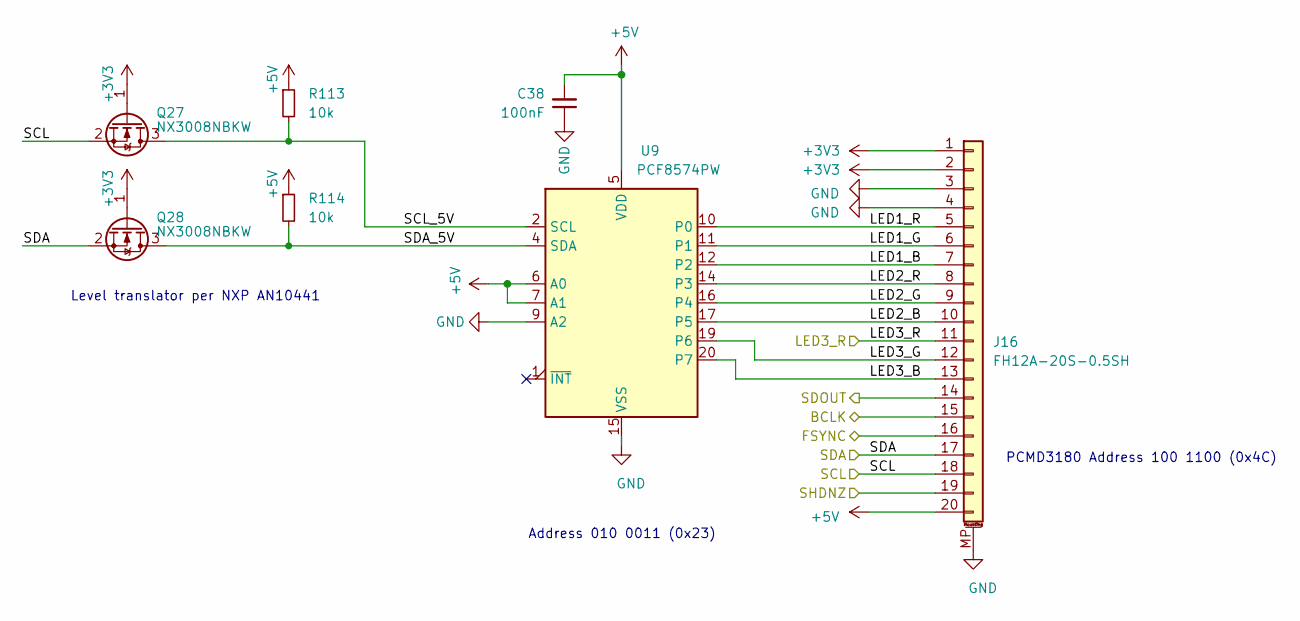
[picture p7: schematic _led_driver.kicad_sch]

Parts:
C38: 100nF; C_0402_1005Metric; Voltage 50V; MPN GRM155R71H104KE14D; Mouser 81-GRM155R71H104KE4D
J16: FH12A-20S-0.5SH; Hirose_FH12-20S-0.5SH_1x20-1MP_P0.50mm_Horizontal; MPN FH12A-20S-0.5SH(55); Digikey HFK120CT-ND
Q27, Q28: NX3008NBKW; SOT-323_SC-70; MPN NX3008NBKW; Digikey 1727-1280-6-ND
R113, R114: 10k; R_0402_1005Metric
U9: PCF8574PW; SSOP-20_4.4x6.5mm_P0.65mm; MPN PCF8574PW; Digikey TI

Connections:
+3V3: J16.1, J16.2, Q27.1 (G), Q28.1 (G); also elsewhere on the board
+5V: C38.2, J16.20, R113.1, R114.1, U9.5 (VDD), U9.6 (A0), U9.7 (A1); also elsewhere on the board
/BCLK: J16.15; also elsewhere on the board
/FSYNC: J16.16; also elsewhere on the board
/LED driver, LED board connections/LED1_B: J16.7, U9.12 (P2)
/LED driver, LED board connections/LED1_G: J16.6, U9.11 (P1)
/LED driver, LED board connections/LED1_R: J16.5, U9.10 (P0)
/LED driver, LED board connections/LED2_B: J16.10, U9.17 (P5)
/LED driver, LED board connections/LED2_G: J16.9, U9.16 (P4)
/LED driver, LED board connections/LED2_R: J16.8, U9.14 (P3)
/LED driver, LED board connections/LED3_B: J16.13, U9.20 (P7)
/LED driver, LED board connections/LED3_G: J16.12, U9.19 (P6)
/LED driver, LED board connections/SCL_5V: Q27.3 (D), R113.2, U9.2 (SCL)
/LED driver, LED board connections/SDA_5V: Q28.3 (D), R114.2, U9.4 (SDA)
/SCL: J16.18, Q27.2 (S); also elsewhere on the board
/SDA: J16.17, Q28.2 (S); also elsewhere on the board
/SDOUT_INT_MIC: J16.14; also elsewhere on the board
/SHDNZ: J16.19; also elsewhere on the board
/nPWR_LED: J16.11; also elsewhere on the board
GND: C38.1, J16.3, J16.4, J16.MP (MountPin), U9.9 (A2), U9.15 (VSS); also elsewhere on the board

Notes on the sheet:
Level translator per NXP AN10441
PCMD3180 Address 100 1100 (0x4C)
Address 010 0011 (0x23)

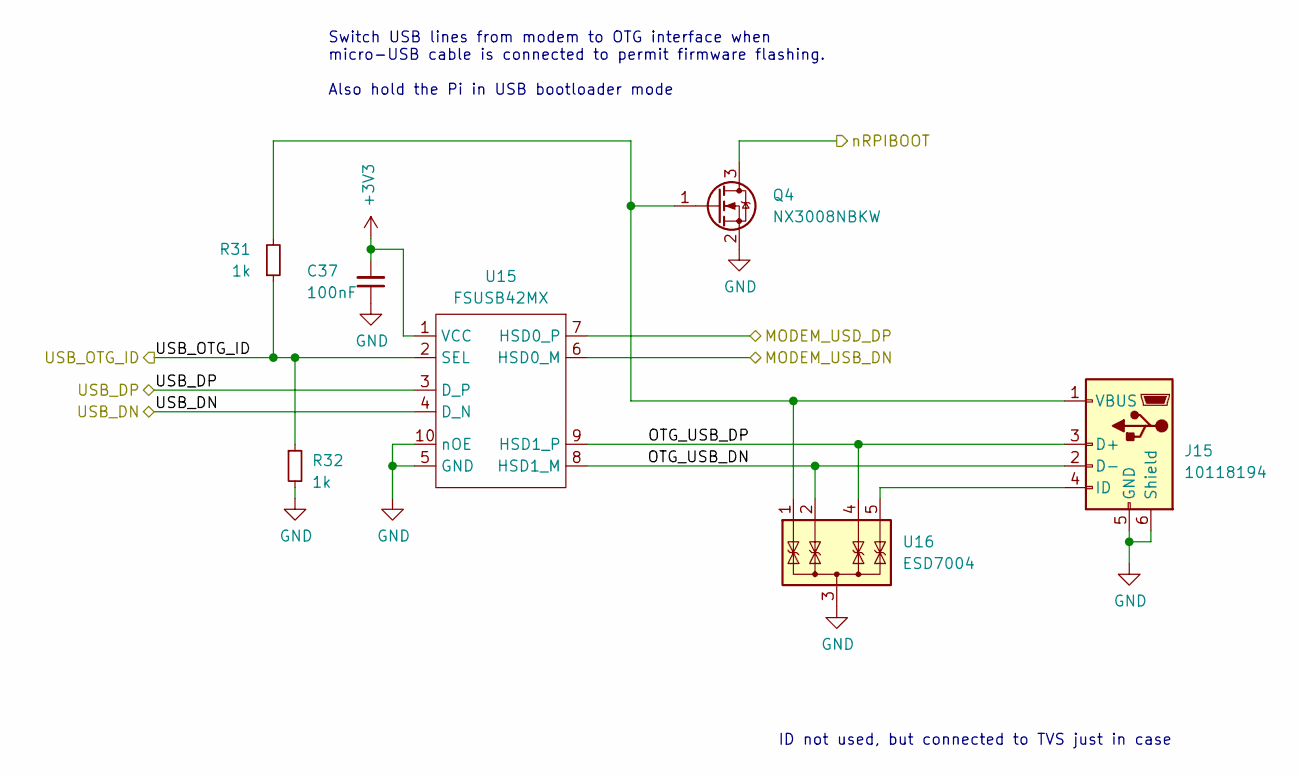
[picture p8: schematic _usb_otg.kicad_sch]

Parts:
C37: 100nF; C_0402_1005Metric; Voltage 50V; MPN GRM155R71H104KE14D; Mouser 81-GRM155R71H104KE4D
J15: 10118194; USB_Micro-B_Amphenol_10118194_Horizontal; MPN 10118194-0001LF; Digikey 609-4618-6-ND
Q4: NX3008NBKW; SOT-323_SC-70; MPN NX3008NBKW; Digikey 1727-1280-6-ND
R31, R32: 1k; R_0402_1005Metric
U15: FSUSB42MX; MSOP-10_3x3mm_P0.5mm; MPN FSUSB42MUX; Digikey FSUSB42MUXDKR-ND
U16: ESD7004; USON-10_2.5x1.0mm_P0.5mm; MPN ESD7004MUTAG; Digikey ESD7004MUTAGOSDKR-ND

Connections:
+3V3: C37.2, U15.1 (VCC); also elsewhere on the board
/MODEM_USB_DN: U15.6 (HSD0_M); also elsewhere on the board
/MODEM_USB_DP: U15.7 (HSD0_P); also elsewhere on the board
/USB-OTG flashing interface/OTG_USB_DN: J15.2 (D-), U15.8 (HSD1_M), U16.2 (IO2), U16.9
/USB-OTG flashing interface/OTG_USB_DP: J15.3 (D+), U15.9 (HSD1_P), U16.4 (IO3), U16.7
/USB_DN: U15.4 (D_N); also elsewhere on the board
/USB_DP: U15.3 (D_P); also elsewhere on the board
/USB_OTG_ID: R31.1, R32.1, U15.2 (SEL); also elsewhere on the board
/nRPIBOOT: Q4.3 (D); also elsewhere on the board
GND: C37.1, J15.5 (GND), J15.6 (Shield), Q4.2 (S), R32.2, U15.5 (GND), U15.10 (nOE), U16.3 (G), U16.8; also elsewhere on the board
unnamed: J15.4 (ID), U16.5 (IO4), U16.6
unnamed: J15.1 (VBUS), Q4.1 (G), R31.2, U16.1 (IO1), U16.10

Notes on the sheet:
Switch USB lines from modem to OTG interface when micro-USB cable is connected to permit firmware flashing. Also hold the Pi in USB bootloader mode
ID not used, but connected to TVS just in case

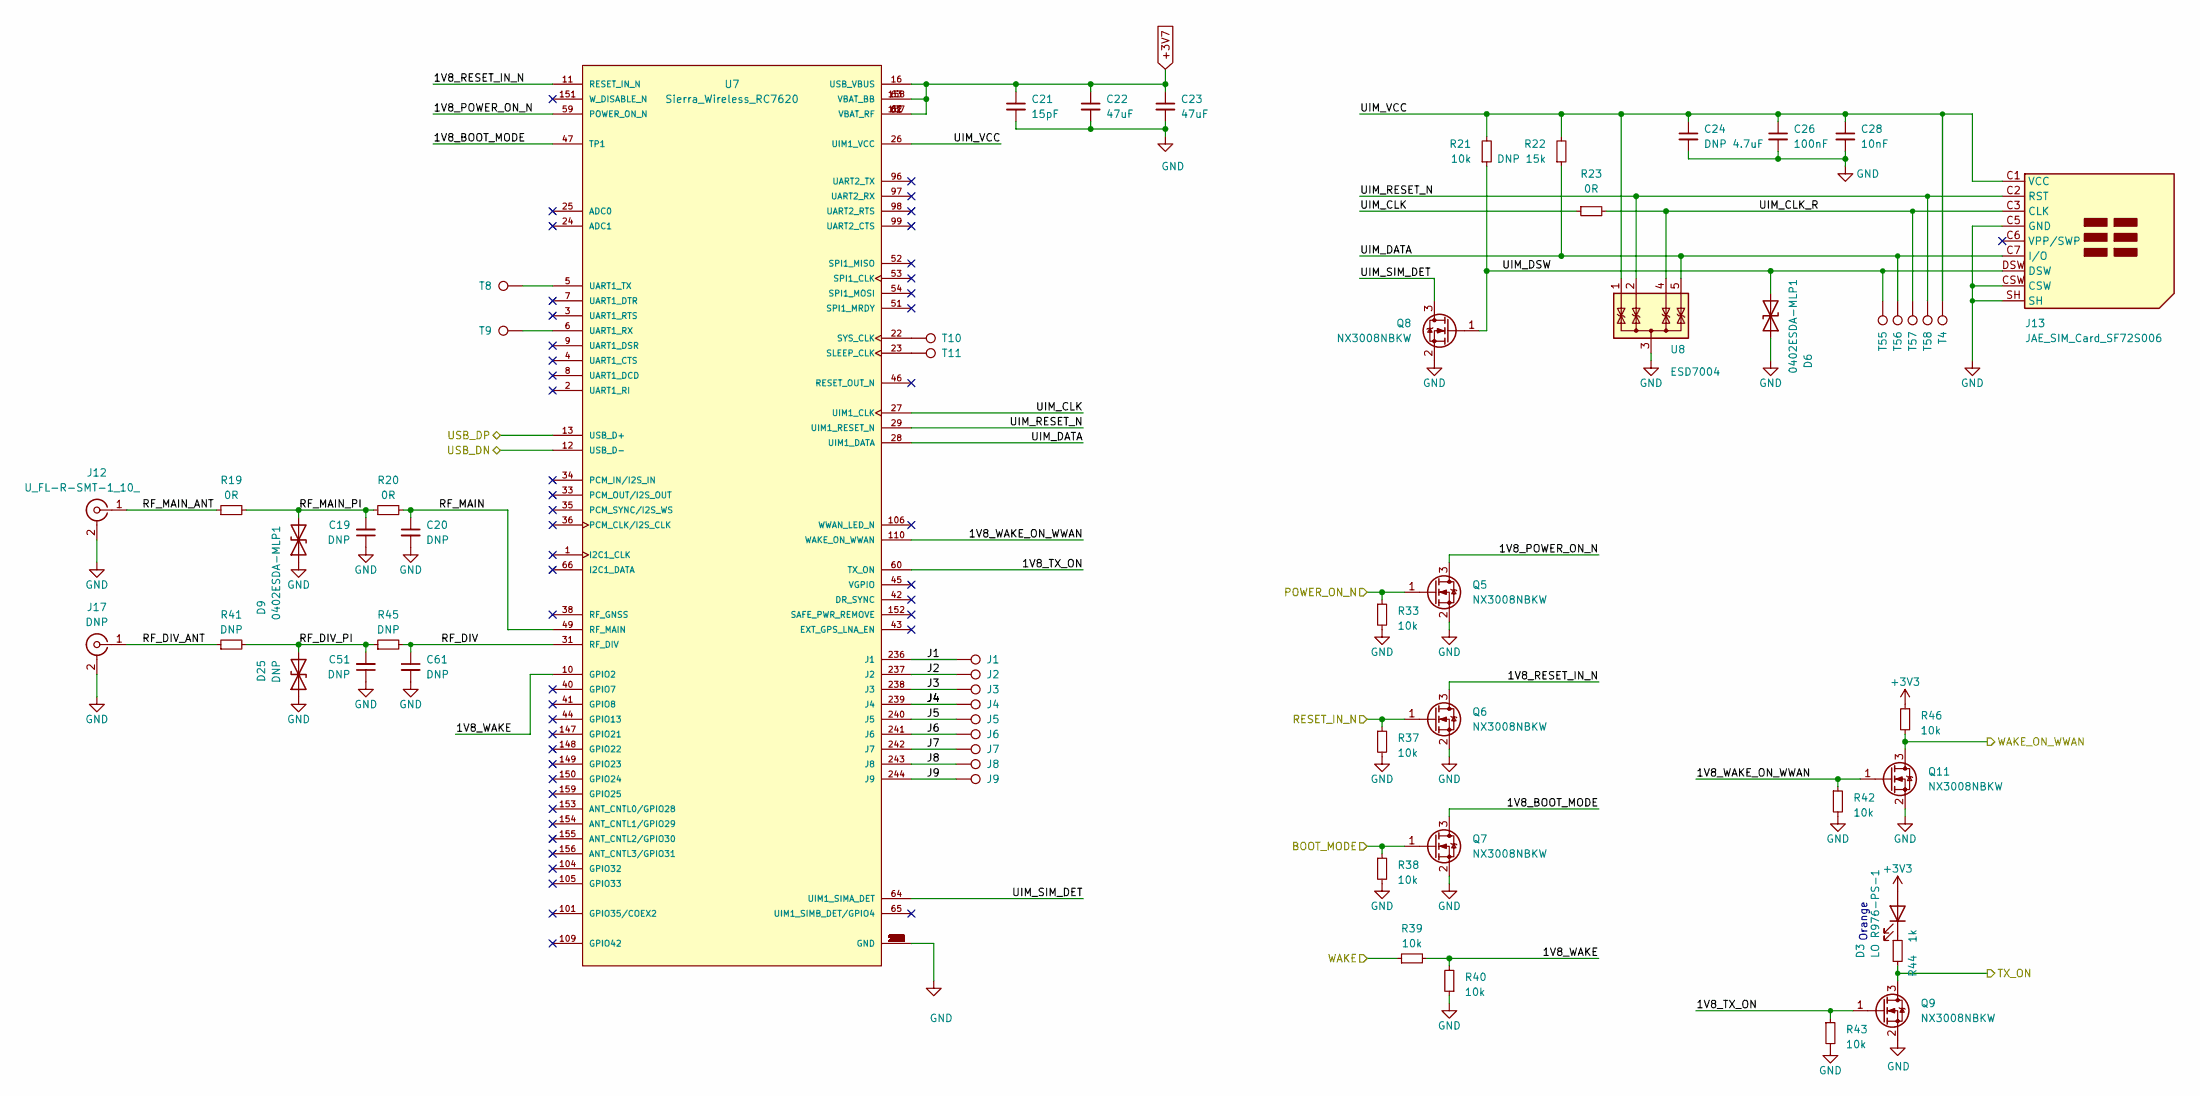
[picture p9: schematic _modem.kicad_sch]

Parts:
C19, C20, C51, C61: DNP; C_0402_1005Metric
C21: 15pF; C_0402_1005Metric
C22, C23: 47uF; C_1206_3216Metric; Voltage 6.3V; MPN GRM31CE70J476ME15L; Mouser 81-GRM31CE70J476ME5L
C24: DNP 4.7uF; C_0603_1608Metric
C26: 100nF; C_0402_1005Metric; Voltage 50V; MPN GRM155R71H104KE14D; Mouser 81-GRM155R71H104KE4D
C28: 10nF; C_0402_1005Metric; Voltage 50V
D3: LO R976-PS-1; CHIPLED-0805; MPN LOR976-PS-1; Digikey 475-2488-6-ND
D6, D9: 0402ESDA-MLP1; D_0402_1005Metric; MPN 0402ESDA-MLP1; Digikey 283-2964-6-ND
D25: DNP; D_0402_1005Metric
J1, J2, J3, J4, J5, J6, J7, J8, J9: TestPoint_Pad_D1.0mm
J12: U_FL-R-SMT-1_10_; U.FL_Hirose_U.FL-R-SMT-1-copper-keepout; MPN 128-0711-201; Digikey J983DKR-ND
J13: JAE_SIM_Card_SF72S006; MPN SF72S006VBDR2500; Digikey 670-2967-6-ND
J17: DNP; U.FL_Hirose_U.FL-R-SMT-1-copper-keepout
Q5, Q6, Q7, Q8, Q9, Q11: NX3008NBKW; SOT-323_SC-70; MPN NX3008NBKW; Digikey 1727-1280-6-ND
R19, R20, R23: 0R; R_0402_1005Metric
R21, R33, R37, R38, R39, R40, R42, R43, R46: 10k; R_0402_1005Metric
R22: DNP 15k; R_0402_1005Metric
R41, R45: DNP; R_0402_1005Metric
R44: 1k; R_0402_1005Metric
T4, T8, T9, T10, T11, T55, T56, T57, T58: TestPoint_Pad_D1.0mm
U7: Sierra_Wireless_RC7620; Cellular_Modem-Sierra-Wireless-module-CF3-ringCD; MPN RC7620
U8: ESD7004; USON-10_2.5x1.0mm_P0.5mm; MPN ESD7004MUTAG; Digikey ESD7004MUTAGOSDKR-ND

Connections:
+3V3: D3.2 (A), R46.1; also elsewhere on the board
+3V7: C21.1, C22.1, C23.1, U7.16 (USB_VBUS), U7.61 (VBAT_RF), U7.62 (VBAT_RF), U7.63 (VBAT_BB), U7.157 (VBAT_RF), U7.158 (VBAT_BB); also elsewhere on the board
/BOOT_MODE: Q7.1 (G), R38.1; also elsewhere on the board
/MODEM_USB_DN: U7.12 (USB_D-); also elsewhere on the board
/MODEM_USB_DP: U7.13 (USB_D+); also elsewhere on the board
/Modem/1V8_BOOT_MODE: Q7.3 (D), U7.47 (TP1)
/Modem/1V8_POWER_ON_N: Q5.3 (D), U7.59 (POWER_ON_N)
/Modem/1V8_RESET_IN_N: Q6.3 (D), U7.11 (RESET_IN_N)
/Modem/1V8_TX_ON: Q9.1 (G), R43.1, U7.60 (TX_ON)
/Modem/1V8_WAKE: R39.2, R40.2, U7.10 (GPIO2)
/Modem/1V8_WAKE_ON_WWAN: Q11.1 (G), R42.1, U7.110 (WAKE_ON_WWAN)
/Modem/J1: J1.1, U7.236 (J1)
/Modem/J2: J2.1, U7.237 (J2)
/Modem/J3: J3.1, U7.238 (J3)
/Modem/J4: J4.1, U7.239 (J4)
/Modem/J5: J5.1, U7.240 (J5)
/Modem/J6: J6.1, U7.241 (J6)
/Modem/J7: J7.1, U7.242 (J7)
/Modem/J8: J8.1, U7.243 (J8)
/Modem/J9: J9.1, U7.244 (J9)
/Modem/RF_DIV: C61.1, R45.2, U7.31 (RF_DIV)
/Modem/RF_DIV_ANT: J17.1 (In), R41.1
/Modem/RF_DIV_PI: C51.2, D25.2 (A2), R41.2, R45.1
/Modem/RF_MAIN: C20.1, R20.2, U7.49 (RF_MAIN)
/Modem/RF_MAIN_ANT: J12.1 (In), R19.1
/Modem/RF_MAIN_PI: C19.2, D9.2 (A2), R19.2, R20.1
/Modem/UIM_CLK: R23.1, U7.27 (UIM1_CLK)
/Modem/UIM_CLK_R: J13.C3 (CLK), R23.2, T57.1, U8.4 (IO3), U8.7
/Modem/UIM_DATA: J13.C7 (I/O), R22.1, T56.1, U7.28 (UIM1_DATA), U8.5 (IO4), U8.6
/Modem/UIM_DSW: D6.2 (A2), J13.DSW, Q8.1 (G), R21.1, T55.1
/Modem/UIM_RESET_N: J13.C2 (RST), T58.1, U7.29 (UIM1_RESET_N), U8.2 (IO2), U8.9
/Modem/UIM_SIM_DET: Q8.3 (D), U7.64 (UIM1_SIMA_DET)
/Modem/UIM_VCC: C24.1, C26.1, C28.1, J13.C1 (VCC), R21.2, R22.2, T4.1, U7.26 (UIM1_VCC), U8.1 (IO1), U8.10
/POWER_ON_N: Q5.1 (G), R33.1; also elsewhere on the board
/RESET_IN_N: Q6.1 (G), R37.1; also elsewhere on the board
/TX_ON: Q9.3 (D), R44.2; also elsewhere on the board
/WAKE: R39.1; also elsewhere on the board
/WAKE_ON_WWAN: Q11.3 (D), R46.2; also elsewhere on the board
GND: C19.1, C20.2, C21.2, C22.2, C23.2, C24.2, C26.2, C28.2, C51.1, C61.2, D6.1 (A1), D9.1 (A1), D25.1 (A1), J12.2 (Ext), J13.C5 (GND), J13.CSW, J13.SH, J17.2 (Ext), Q5.2 (S), Q6.2 (S), Q7.2 (S), Q8.2 (S), Q9.2 (S), Q11.2 (S), R33.2, R37.2, R38.2, R40.1, R42.2, R43.2, U7.30 (GND), U7.32 (GND), U7.37 (GND), U7.39 (GND), U7.48 (GND), U7.50 (GND), U7.67 (GND), U7.68 (GND), U7.69 (GND), U7.70 (GND), U7.111 (GND), U7.113 (GND), U7.125 (GND), U7.128 (GND), U7.136 (GND), U7.139 (GND), U7.167 (GND), U7.168 (GND), U7.169 (GND), U7.170 (GND), U7.171 (GND), U7.172 (GND), U7.173 (GND), U7.174 (GND), U7.175 (GND), U7.176 (GND), U7.177 (GND), U7.178 (GND), U7.179 (GND), U7.180 (GND), U7.181 (GND), U7.182 (GND), U7.183 (GND), U7.184 (GND), U7.185 (GND), U7.186 (GND), U7.187 (GND), U7.188 (GND), U7.189 (GND), U7.190 (GND), U7.191 (GND), U7.192 (GND), U7.193 (GND), U7.194 (GND), U7.195 (GND), U7.196 (GND), U7.197 (GND), U7.198 (GND), U7.199 (GND), U7.200 (GND), U7.201 (GND), U7.202 (GND), U7.203 (GND), U7.204 (GND), U7.205 (GND), U7.206 (GND), U7.207 (GND), U7.208 (GND), U7.209 (GND), U7.210 (GND), U7.211 (GND), U7.212 (GND), U7.213 (GND), U7.214 (GND), U7.215 (GND), U7.216 (GND), U7.217 (GND), U7.218 (GND), U7.219 (GND), U7.220 (GND), U7.221 (GND), U7.222 (GND), U7.223 (GND), U7.224 (GND), U7.225 (GND), U7.226 (GND), U7.227 (GND), U7.228 (GND), U7.229 (GND), U7.230 (GND), U7.231 (GND), U7.232 (GND), U7.233 (GND), U7.234 (GND), U8.3 (G), U8.8; also elsewhere on the board
unnamed: D3.1 (K), R44.1
unnamed: T11.1, U7.23 (SLEEP_CLK)
unnamed: T10.1, U7.22 (SYS_CLK)
unnamed: T9.1, U7.6 (UART1_RX)
unnamed: T8.1, U7.5 (UART1_TX)

Notes on the sheet:
Orange
