Benedict-Carling/bugg-hardware-main/r6/src/bugg-main-r6.kicad_pcb

## KiCad design r6/src/bugg-main-r6.kicad_pcb (continued)

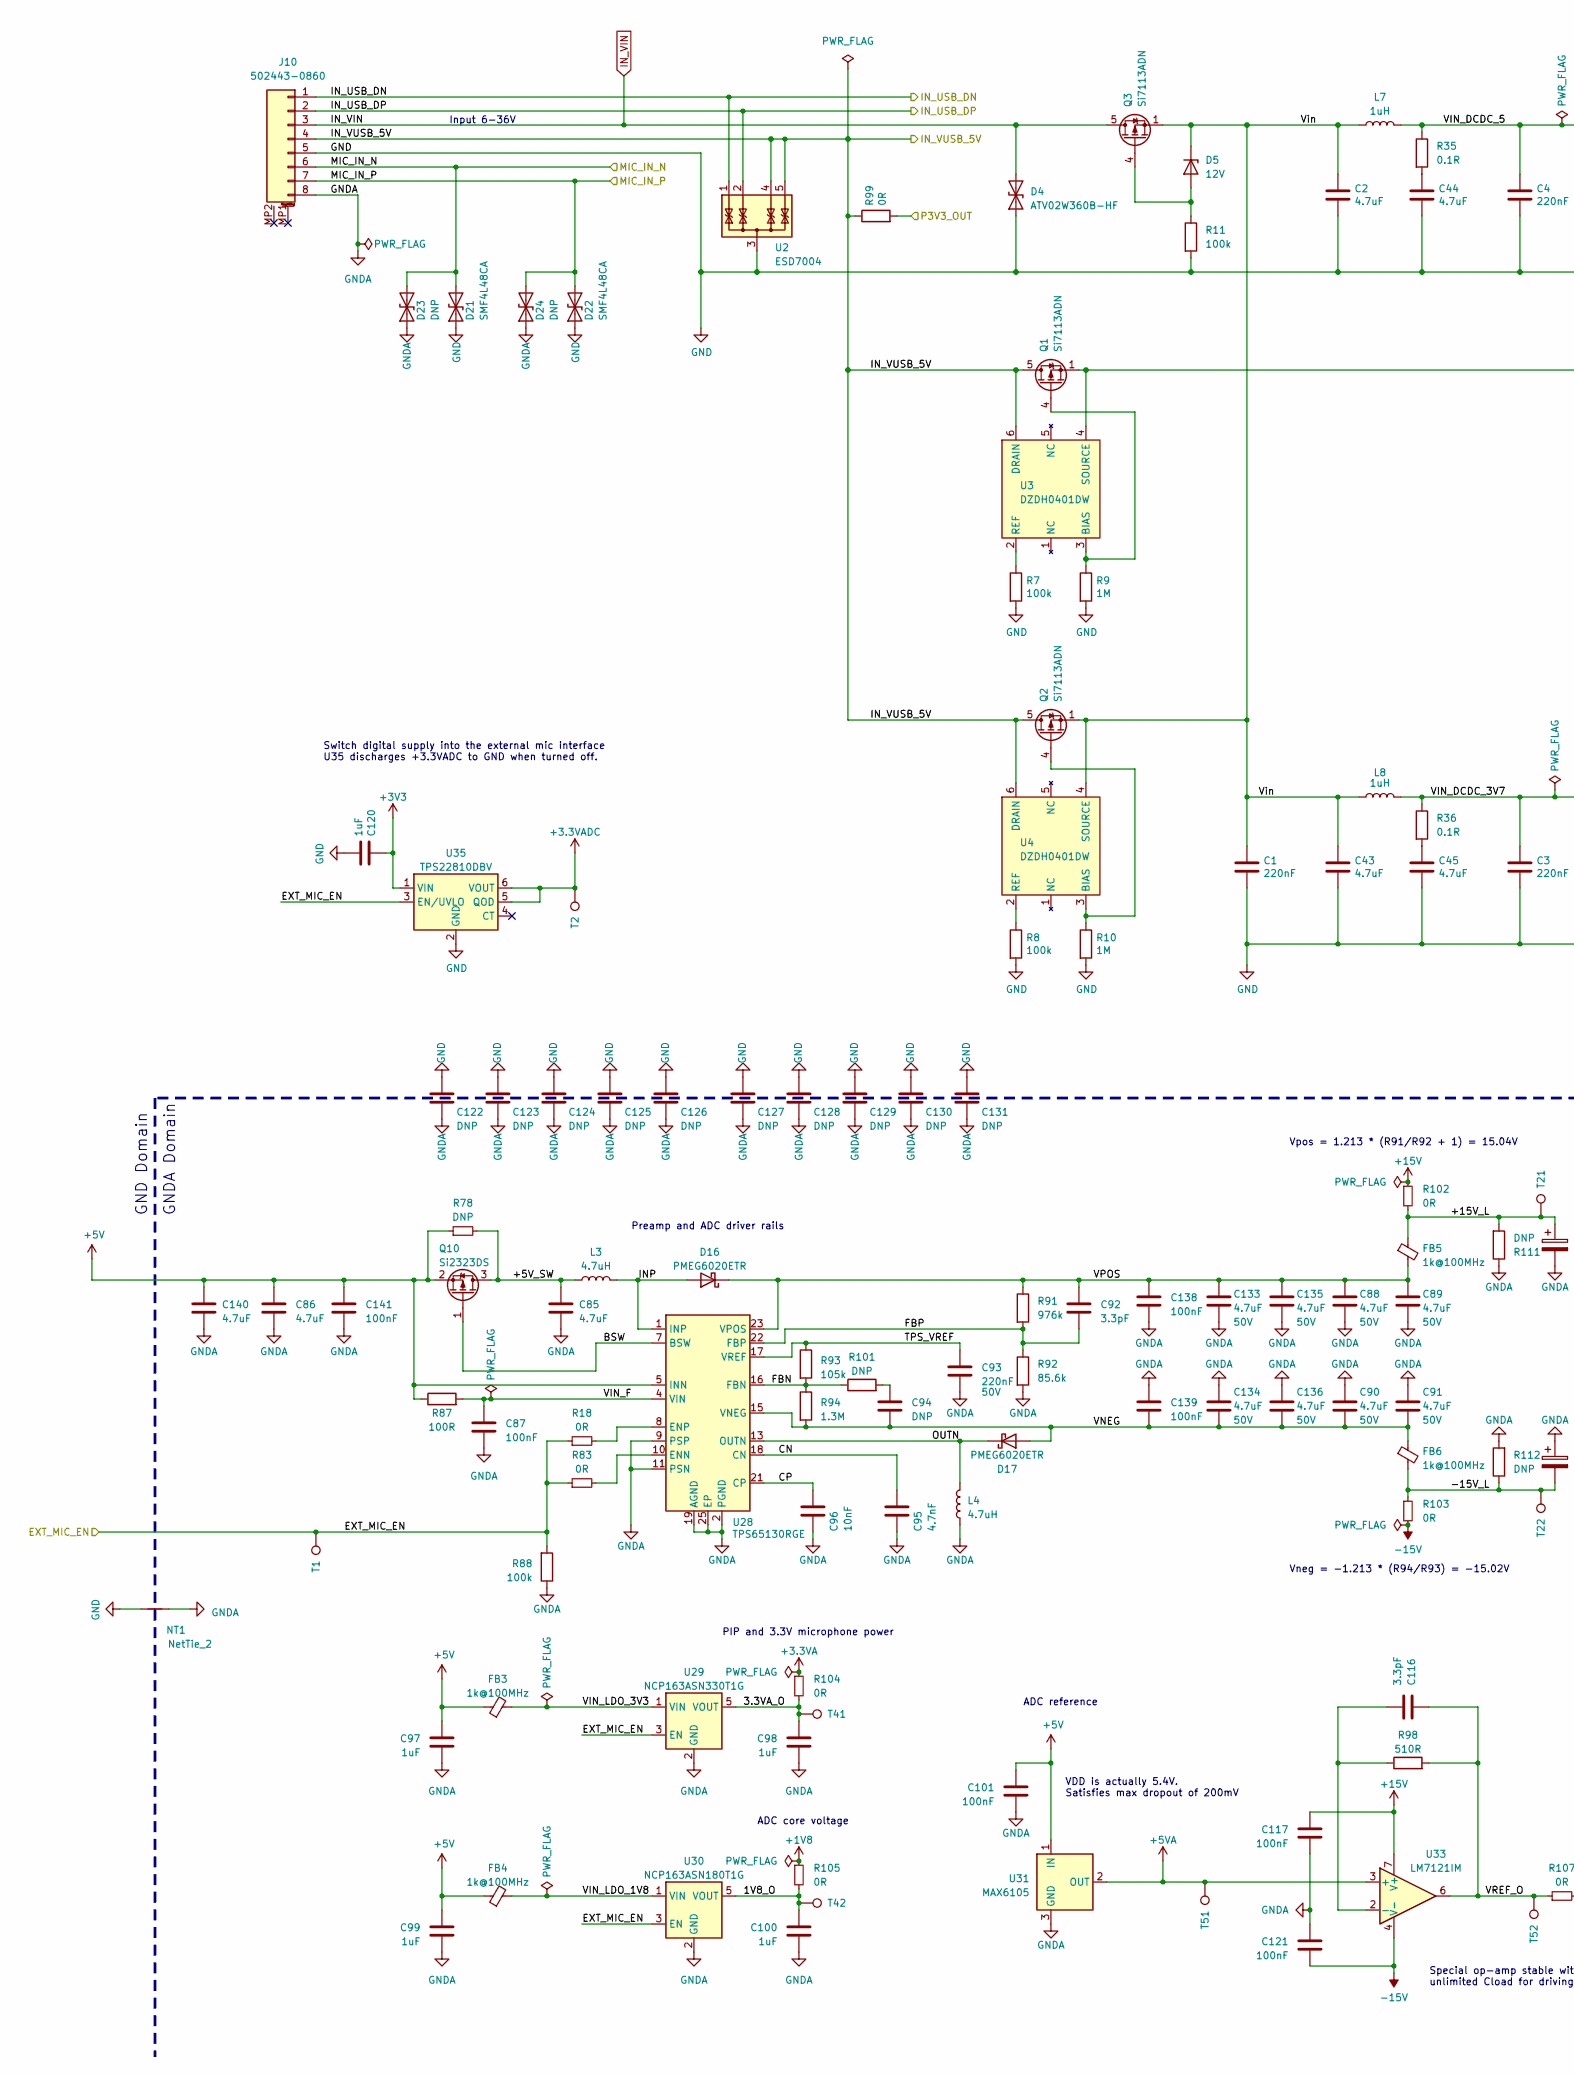
[picture p10: schematic _power.kicad_sch, part in row 1, column 1]

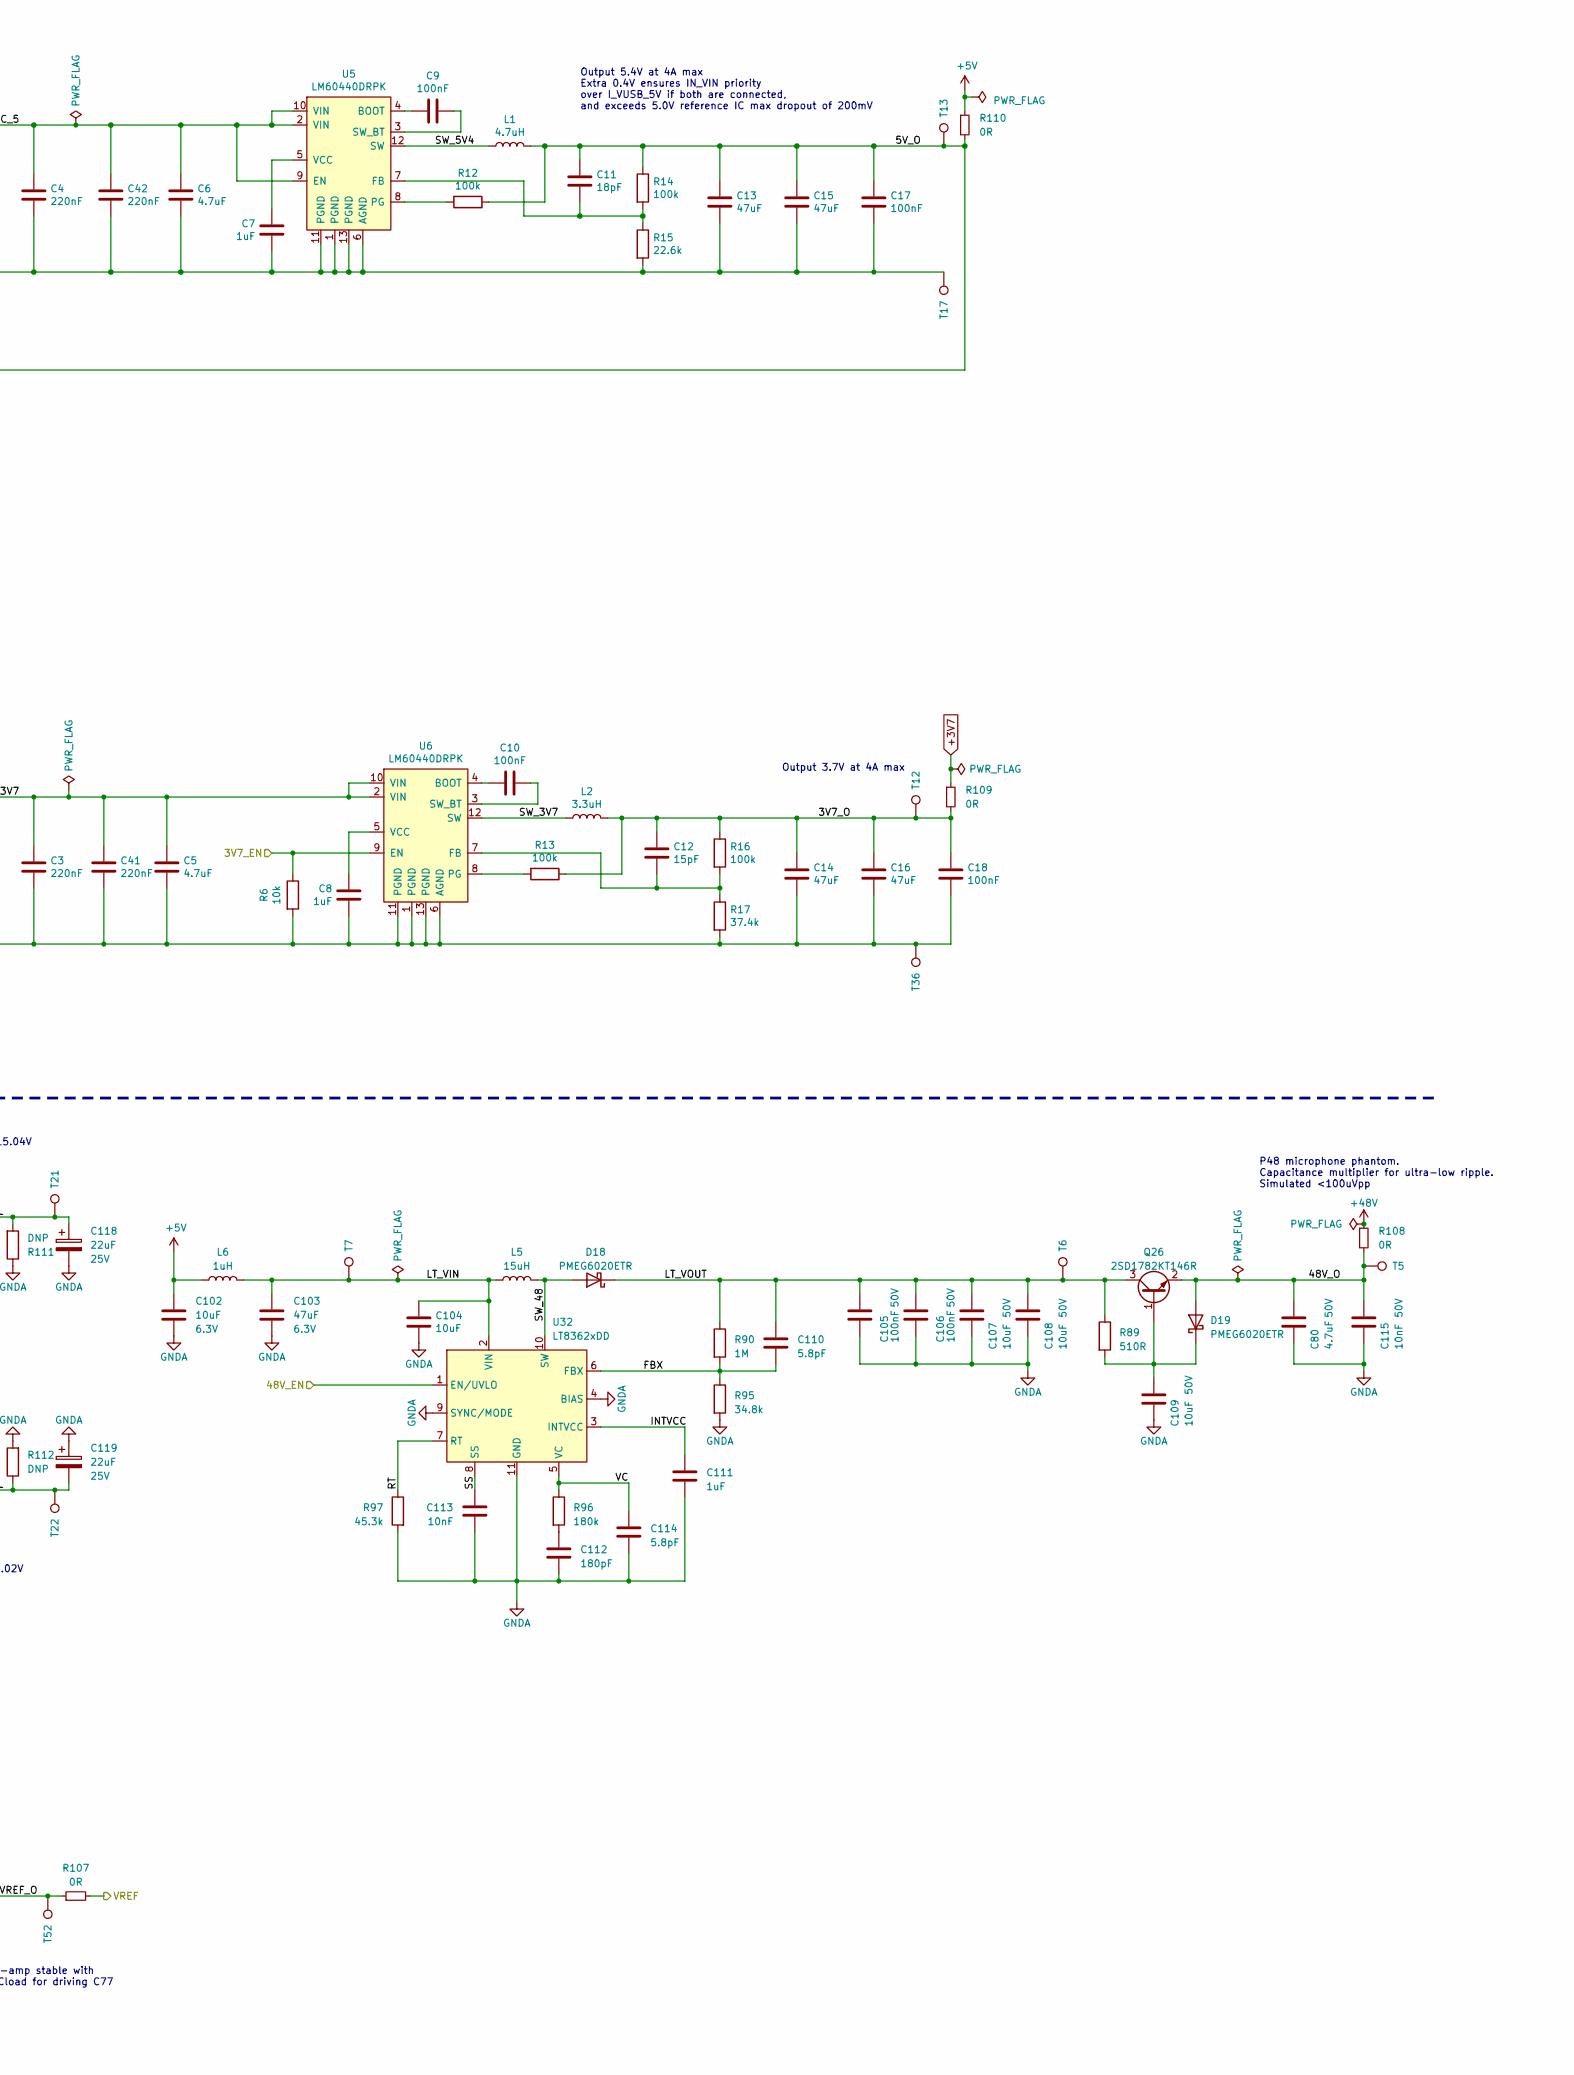
[picture p11: schematic _power.kicad_sch, part in row 1, column 2]

Parts:
C1, C3, C4, C41, C42, C93: 220nF; C_0402_1005Metric; Voltage 50V; MPN GRM155R61H224ME01J; Digikey 490-GRM155R61H224ME01JDKR-ND
C2, C5, C6, C43, C44, C45, C80, C88, C89, C90, C91, C133, C134, C135, C136: 4.7uF; C_1206_3216Metric; Voltage 50V; MPN CL31B475KBHNNNE
C7, C8, C97, C98, C99, C100, C111, C120: 1uF; C_0402_1005Metric; Voltage 6.3V; MPN GRM155C81C105KE15D; Mouser 81-GRM155C81C105KE5D
C9, C10, C17, C18, C87, C101, C105, C106, C117, C121, C138, C139, C141: 100nF; C_0402_1005Metric; Voltage 50V; MPN GRM155R71H104KE14D; Mouser 81-GRM155R71H104KE4D
C11: 18pF; C_0402_1005Metric
C12: 15pF; C_0402_1005Metric
C13, C14, C15, C16, C103: 47uF; C_1206_3216Metric; Voltage 6.3V; MPN GRM31CE70J476ME15L; Mouser 81-GRM31CE70J476ME5L
C85, C86, C140: 4.7uF; C_0603_1608Metric; Voltage 6.3V; MPN CL10A475KQ8NNNC
C92, C116: 3.3pF; C_0402_1005Metric
C94, C122, C123, C124, C125, C126: DNP; C_0402_1005Metric
C95: 4.7nF; C_0402_1005Metric
C96, C113, C115: 10nF; C_0402_1005Metric; Voltage 50V
C102, C104: 10uF; C_0603_1608Metric; Voltage 6.3V; MPN CL10A106MQ8NNNC; Mouser 187-CL10A106MQ8NNNC
C107, C108, C109: 10uF; C_1210_3225Metric; Voltage 50V; MPN GCM32EC71H106KA03L; Mouser 81-GCM32EC71H106KA3L
C110, C114: 5.8pF; C_0402_1005Metric
C112: 180pF; C_0402_1005Metric
C118, C119: 22uF; CP_Elec_5x5.8; Voltage 25V; MPN UCL1E220MCL1GS; Digikey 493-3932-1-ND
C127, C128, C129, C130, C131: DNP; C_1206_3216Metric
D4: ATV02W360B-HF; D_SOD-123; MPN ATV02W360B-HF; Digikey 641-1664-6-ND
D5: 12V; D_SOD-123; MPN BZT52C12-13-F; Digikey BZT52C1213-FDIDKR-ND
D16, D17, D18, D19: PMEG6020ETR; Nexperia_CFP3_SOD-123W; MPN PMEG6020ETR,115; Digikey 1727-1347-1-ND
D21, D22: SMF4L48CA; D_SOD-123F; MPN SMF4L48CA; Mouser 576-SMF4L48CA
D23, D24: DNP; D_SOD-123F
FB3, FB4, FB5, FB6: 1k@100MHz; L_0603_1608Metric; MPN BLM18KG102SN1D; Digikey 490-17349-1-ND
J10: 502443-0860; Molex_CLIK-Mate_502443-0870_1x08-2MP_P2.00mm_Vertical; MPN 502443-0860; Digikey Molex
L1: 4.7uH; L_Coilcraft_XAL5030-XXX; MPN XAL5030-472MEC; Mouser 994-XAL5030-472MEC
L2: 3.3uH; L_Coilcraft_XAL5030-XXX; MPN XAL5030-332MEC; Mouser 994-XAL5030-332MEC
L3, L4: 4.7uH; L_Coilcraft_XxL4030; MPN XAL4030-472MEC; Mouser 994-XAL4030-472MEC
L5: 15uH; L_Wuerth_MAPI-4020; MPN 74438356150; Mouser 710-74438356150
L6, L7, L8: 1uH; L_1008_2520Metric; MPN LQM2HPN1R0MJHL; Digikey 490-12068-6-ND
NT1: NetTie_2; NetTie-2_SMD_Pad2.0mm-inner1
Q1, Q2, Q3: Si7113ADN; Vishay_PowerPAK_1212-8_Single; MPN SI7113ADN-T1-GE3; Digikey SI7113ADN-T1-GE3DKR-ND
Q10: Si2323DS; SOT-23; MPN SI2323DS-T1
Q26: 2SD1782KT146R; SC-59; MPN 2SD1782KT146R; Mouser 755-2SD1782KT146R
R6: 10k; R_0402_1005Metric
R7, R8, R11, R12, R13, R14, R16, R88: 100k; R_0402_1005Metric
R9, R10, R90: 1M; R_0402_1005Metric
R15: 22.6k; R_0402_1005Metric
R17: 37.4k; R_0402_1005Metric
R18, R83, R99, R102, R103, R107, R108: 0R; R_0402_1005Metric
R35, R36: 0.1R; R_0402_1005Metric
R78, R101: DNP; R_0402_1005Metric
R87: 100R; R_0402_1005Metric
R89, R98: 510R; R_0402_1005Metric
R91: 976k; R_0402_1005Metric
R92: 85.6k; R_0402_1005Metric
R93: 105k; R_0402_1005Metric
R94: 1.3M; R_0402_1005Metric
R95: 34.8k; R_0402_1005Metric
R96: 180k; R_0402_1005Metric
R97: 45.3k; R_0402_1005Metric
R104, R105, R109, R110: 0R; R_0603_1608Metric
R111, R112: DNP; R_0805_2012Metric
T1, T2, T5, T6, T7, T12, T13, T17, T21, T22, T36, T41, T42, T51, T52: TestPoint_Pad_D1.0mm
U2: ESD7004; USON-10_2.5x1.0mm_P0.5mm; MPN ESD7004MUTAG; Digikey ESD7004MUTAGOSDKR-ND
U3, U4: DZDH0401DW; SOT-363_SC-70-6; MPN DZDH0401DW; Digikey 31-DZDH0401DW-7DKR-ND
U5, U6: LM60440DRPK; WQFN-HR-13; MPN LM60440DRPK; Digikey 595-LM60440DRPKR
U28: TPS65130RGE; VQFN-24-1EP_4x4mm_P0.5mm_EP2.45x2.45mm_ThermalVias; MPN TPS65130RGE; Digikey 296-41861
U29: NCP163ASN330T1G; SOT-23-5; MPN NCP163ASN330T1G; Mouser 863-NCP163ASN330T1G
U30: NCP163ASN180T1G; SOT-23-5; MPN NCP163ASN180T1G; Mouser 863-NCP163ASN180T1G
U31: MAX6105; SOT-23; MPN MAX6105EUR+T; Digikey MAX6105EUR+TCT-ND
U32: LT8362xDD; DFN-10-1EP_3x3mm_P0.5mm_EP1.65x2.38mm; MPN LT8362; Mouser LT8362HDD#PBF
U33: LM7121IM; SOIC-8_3.9x4.9mm_P1.27mm; MPN LM7121IM; Mouser 926-LM7121IMX/NOPB
U35: TPS22810DBV; SOT-23-6; MPN TPS22810DBV; Mouser 595-TPS22810TDBVRQ1

Connections:
+1V8: R105.1; also elsewhere on the board
+3.3VA: R104.1; also elsewhere on the board
+3.3VADC: T2.1, U35.5 (QOD), U35.6 (VOUT); also elsewhere on the board
+3V3: C120.2, U35.1 (VIN); also elsewhere on the board
+3V7: R109.1; also elsewhere on the board
+5V: C86.1, C97.1, C99.1, C101.1, C102.1, C140.1, C141.1, FB3.1, FB4.1, L6.1, Q10.2 (S), R78.1, R87.1, R110.1, U28.5 (INN), U28.6 (INN), U31.1 (IN); also elsewhere on the board
+5VA: T51.1, U31.2 (OUT), U33.3 (+); also elsewhere on the board
+15V: C117.1, R102.1, U33.7 (V+); also elsewhere on the board
+48V: R108.1; also elsewhere on the board
-15V: C121.2, R103.2, U33.4 (V-); also elsewhere on the board
/3V7_EN: R6.1, U6.9 (EN); also elsewhere on the board
/48V_EN: U32.1 (EN/UVLO); also elsewhere on the board
/EXT_MIC_EN: R18.1, R83.1, R88.2, T1.1, U29.3 (EN), U30.3 (EN), U35.3 (EN/UVLO); also elsewhere on the board
/MIC_IN_N: D21.2 (A2), D23.2 (A2), J10.6; also elsewhere on the board
/MIC_IN_P: D22.2 (A2), D24.2 (A2), J10.7; also elsewhere on the board
/P3V3_OUT: R99.2; also elsewhere on the board
/Power and input connector/1V8_O: C100.1, R105.2, T42.1, U30.5 (VOUT)
/Power and input connector/3.3VA_O: C98.1, R104.2, T41.1, U29.5 (VOUT)
/Power and input connector/3V7_O: C12.1, C14.1, C16.1, C18.1, L2.2, R13.1, R16.1, R109.2, T12.1
/Power and input connector/5V_O: C11.1, C13.1, C15.1, C17.1, L1.2, Q1.1 (S), Q1.2 (S), Q1.3 (S), R12.1, R14.1, R110.2, T13.1, U3.4 (SOURCE)
/Power and input connector/48V_O: C80.1, C115.1, D19.2 (A), Q26.2 (E), R108.2, T5.1
/Power and input connector/+5V_SW: C85.1, L3.1, Q10.3 (D), R78.2
/Power and input connector/+15V_L: C118.1, FB5.1, R102.2, R111.2, T21.1
/Power and input connector/-15V_L: C119.2, FB6.2, R103.1, R112.1, T22.1
/Power and input connector/BSW: Q10.1 (G), U28.7 (BSW)
/Power and input connector/CN: C95.1, U28.18 (CN)
/Power and input connector/CP: C96.1, U28.21 (CP)
/Power and input connector/FBN: R93.2, R94.1, R101.1, U28.16 (FBN)
/Power and input connector/FBP: C92.2, R91.2, R92.1, U28.22 (FBP)
/Power and input connector/FBX: C110.2, R90.2, R95.1, U32.6 (FBX)
/Power and input connector/INP: D16.2 (A), L3.2, U28.1 (INP), U28.24 (INP)
/Power and input connector/INTVCC: C111.1, U32.3 (INTVCC)
/Power and input connector/LT_VIN: C103.1, C104.2, L5.1, L6.2, T7.1, U32.2 (VIN)
/Power and input connector/LT_VOUT: C105.1, C106.1, C107.1, C108.1, C110.1, D18.1 (K), Q26.3 (C), R89.1, R90.1, T6.1
/Power and input connector/OUTN: D17.1 (K), L4.2, U28.13 (OUTN), U28.14 (OUTN)
/Power and input connector/RT: R97.1, U32.7 (RT)
/Power and input connector/SS: C113.1, U32.8 (SS)
/Power and input connector/SW_3V7: L2.1, U6.12 (SW)
/Power and input connector/SW_5V4: L1.1, U5.12 (SW)
/Power and input connector/SW_48: D18.2 (A), L5.2, U32.10 (SW)
/Power and input connector/TPS_VREF: C93.1, R93.1, U28.17 (VREF)
/Power and input connector/VC: C114.1, R96.1, U32.5 (VC)
/Power and input connector/VIN_DCDC_3V7: C3.1, C5.1, C41.1, L8.2, R36.1, U6.2 (VIN), U6.10 (VIN)
/Power and input connector/VIN_DCDC_5: C4.1, C6.1, C42.1, L7.2, R35.1, U5.2 (VIN), U5.9 (EN), U5.10 (VIN)
/Power and input connector/VIN_F: C87.1, R87.2, U28.4 (VIN)
/Power and input connector/VIN_LDO_1V8: FB4.2, U30.1 (VIN)
/Power and input connector/VIN_LDO_3V3: FB3.2, U29.1 (VIN)
/Power and input connector/VNEG: C90.2, C91.2, C94.2, C134.2, C136.2, C139.2, D17.2 (A), FB6.1, R94.2, U28.15 (VNEG)
/Power and input connector/VPOS: C88.1, C89.1, C92.1, C133.1, C135.1, C138.1, D16.1 (K), FB5.2, R91.1, U28.23 (VPOS)
/Power and input connector/VREF_O: C116.1, R98.2, R107.1, T52.1, U33.6
/Power and input connector/Vin: C1.1, C2.1, C43.1, D5.1 (K), L7.1, L8.1, Q2.1 (S), Q2.2 (S), Q2.3 (S), Q3.1 (S), Q3.2 (S), Q3.3 (S), U4.4 (SOURCE)
/USB_UART_DN: J10.1, U2.1 (IO1), U2.10; also elsewhere on the board
/USB_UART_DP: J10.2, U2.2 (IO2), U2.9; also elsewhere on the board
/VREF: R107.2; also elsewhere on the board
GND: C1.2, C2.2, C3.2, C4.2, C5.2, C6.2, C7.1, C8.1, C13.2, C14.2, C15.2, C16.2, C17.2, C18.2, C41.2, C42.2, C43.2, C44.2, C45.2, C120.1, C122.2, C123.2, C124.2, C125.2, C126.2, C127.2, C128.2, C129.2, C130.2, C131.2, D4.1 (A1), D21.1 (A1), D22.1 (A1), J10.5, NT1.1, R6.2, R7.2, R8.2, R9.2, R10.2, R11.2, R15.2, R17.2, T17.1, T36.1, U2.3 (G), U2.8, U5.1 (PGND), U5.6 (AGND), U5.11 (PGND), U5.13 (PGND), U6.1 (PGND), U6.6 (AGND), U6.11 (PGND), U6.13 (PGND), U35.2 (GND); also elsewhere on the board
GNDA: C80.2, C85.2, C86.2, C87.2, C88.2, C89.2, C90.1, C91.1, C93.2, C95.2, C96.2, C97.2, C98.2, C99.2, C100.2, C101.2, C102.2, C103.2, C104.1, C105.2, C106.2, C107.2, C108.2, C109.2, C111.2, C112.2, C113.2, C114.2, C115.2, C117.2, C118.2, C119.1, C121.1, C122.1, C123.1, C124.1, C125.1, C126.1, C127.1, C128.1, C129.1, C130.1, C131.1, C133.2, C134.1, C135.2, C136.1, C138.2, C139.1, C140.2, C141.2, D23.1 (A1), D24.1 (A1), J10.8, L4.1, NT1.2, R88.1, R92.2, R95.2, R97.2, R111.1, R112.2, U28.2 (PGND), U28.3 (PGND), U28.9 (PSP), U28.11 (PSN), U28.19 (AGND), U28.25 (EP), U29.2 (GND), U30.2 (GND), U31.3 (GND), U32.4 (BIAS), U32.9 (SYNC/MODE), U32.11 (GND); also elsewhere on the board
IN_VIN: D4.2 (A2), J10.3, Q3.5 (D); also elsewhere on the board
unnamed: C44.1, R35.2
unnamed: C45.1, R36.2
unnamed: C94.1, R101.2
unnamed: C112.1, R96.2
unnamed: D5.2 (A), Q3.4 (G), R11.1
unnamed: C109.1, D19.1 (K), Q26.1 (B), R89.2
unnamed: Q1.4 (G), R9.1, U3.3 (BIAS)
unnamed: Q2.4 (G), R10.1, U4.3 (BIAS)
unnamed: R7.1, U3.2 (REF)
unnamed: R8.1, U4.2 (REF)
unnamed: C9.2, U5.4 (BOOT)
unnamed: C11.2, R14.2, R15.1, U5.7 (FB)
unnamed: R12.2, U5.8 (PG)
unnamed: C9.1, U5.3 (SW_BT)
unnamed: C7.2, U5.5 (VCC)
unnamed: C10.1, U6.4 (BOOT)
unnamed: C12.2, R16.2, R17.1, U6.7 (FB)
unnamed: R13.2, U6.8 (PG)
unnamed: C10.2, U6.3 (SW_BT)
unnamed: C8.2, U6.5 (VCC)
unnamed: R83.2, U28.10 (ENN)
unnamed: R18.2, U28.8 (ENP)
unnamed: C116.2, R98.1, U33.2 (-)
VBUS: J10.4, Q1.5 (D), Q2.5 (D), R99.1, U2.4 (IO3), U2.5 (IO4), U2.6, U2.7, U3.6 (DRAIN), U4.6 (DRAIN); also elsewhere on the board

Notes on the sheet:
Special op-amp stable with unlimited Cload for driving C77
Output 5.4V at 4A max Extra 0.4V ensures IN_VIN priority over I_VUSB_5V if both are connected, and exceeds 5.0V reference IC max dropout of 200mV
Input 6-36V
GNDA Domain
Vneg = -1.213 * (R94/R93) = -15.02V
VDD is actually 5.4V. Satisfies max dropout of 200mV
P48 microphone phantom. Capacitance multiplier for ultra-low ripple. Simulated <100uVpp
Output 3.7V at 4A max
Switch digital supply into the external mic interface U35 discharges +3.3VADC to GND when turned off.
ADC core voltage
Preamp and ADC driver rails
GND Domain
PIP and 3.3V microphone power
Vpos = 1.213 * (R91/R92 + 1) = 15.04V
ADC reference

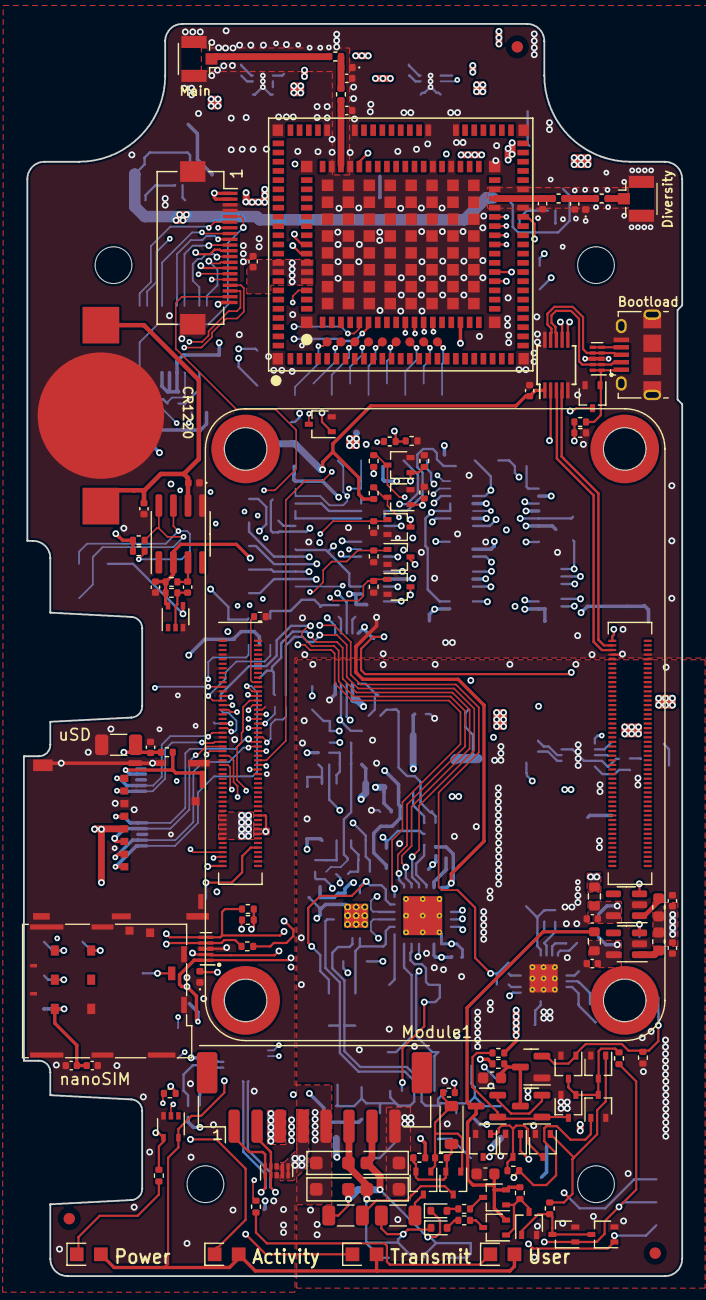
[picture p12: board bugg-main-r6.kicad_pcb from above]

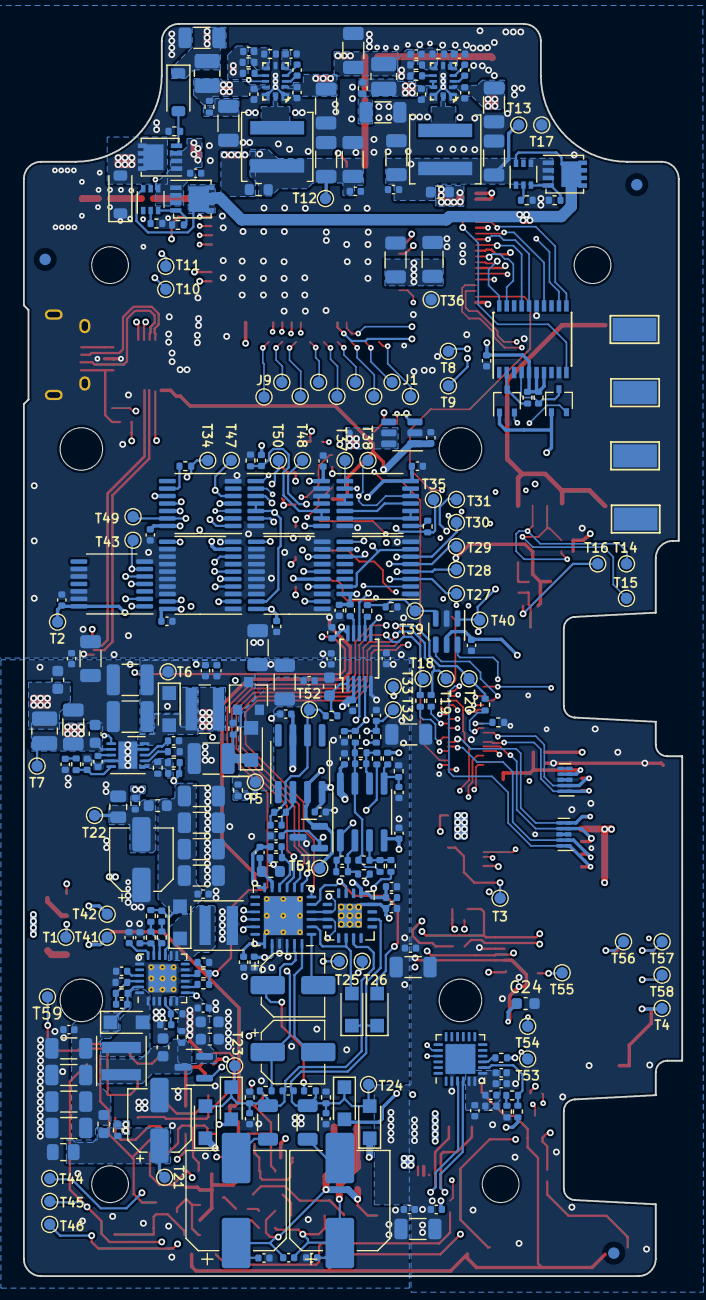
[picture p13: board bugg-main-r6.kicad_pcb from below]

Board: 6 copper layers, 57.3 x 109.0 mm, 460 parts (326 on the bottom side), 241 nets.
